Robiswell/Euler_Rover_2026/docs/README.md

# Identity Rover Documentation

[Back to main README](../README.md)

Detailed reference docs for the Identity rover build, organized so the main README can stay focused while reviewers can still inspect the full technical record.

## Build And Hardware

| Document | Purpose |
| --- | --- |
| [Hardware Reference](hardware.md) | Hardware stack, measured geometry, CAD links, tread construction, and BOM routing |
| [Bill of Materials](BOM.md) | Categorized purchasing BOM with source links, package quantities, and integration notes |
| [Purchasing BOM CSV](purchasing-bom.csv) | Exported source sheet used to build the categorized BOM |

## Software And Controls

| Document | Purpose |
| --- | --- |
| [Gait Control Reference](gait-control.md) | Buehler-clock gait modes, smart-servo feedback, gait visuals, and terrain overlays |
| [Software Map](software-map.md) | Runtime files, test programs, calibration tools, analysis helpers, and launch modes |
| [Architecture Overview](architecture.md) | Architecture diagrams and links to the full software architecture document |

## Validation And Media

| Document | Purpose |
| --- | --- |
| [Validation Reference](validation.md) | Field results, terrain signals, servo load margin, simulation coverage, and known limits |
| [Media Gallery](media.md) | Field demos and course success runs |
| [Presentation Slide Gallery](paper-presentation-slides.md) | View-friendly image gallery generated from the full paper presentation PDF |

## Releases

| Document | Purpose |
| --- | --- |
| [Release History](releases.md) | Public release trail for final, competition, and earlier rover milestones |
