Robiswell/Euler_Rover_2026/docs/architecture.md

# Architecture Overview

[Back to main README](../README.md)

Architecture reference for the Identity rover software stack, with diagram links and routing to the full software architecture document.

## Primary Architecture Document

See [`../ARCHITECTURE.md`](../ARCHITECTURE.md) for the full software architecture map, including the Brain/Heart process split, sensor pipeline, terrain overlay, safety governors, and simulation coverage.

## Runtime Split

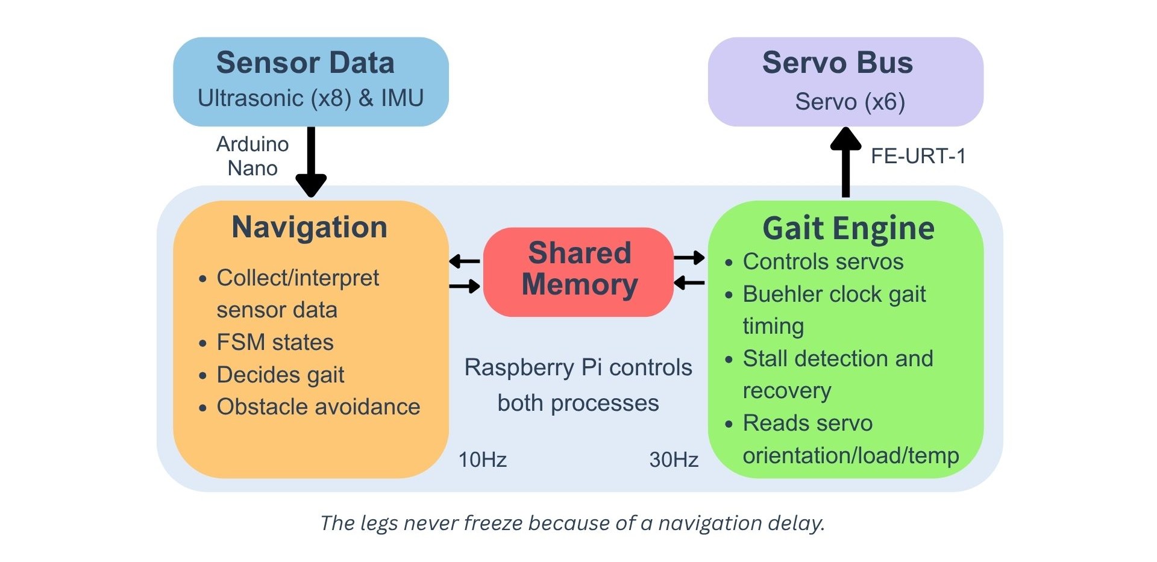
[picture p7: docs/assets/brain-heart-process-split.jpg]
Brain/Heart process split diagram


The Brain process handles sensor interpretation, terrain classification, obstacle/cliff logic, and navigation state transitions. The Heart process runs the timing-critical gait loop, computes servo commands, reads STS3215 position/load/speed telemetry, applies safety governors, and keeps motor control isolated from slower navigation work.

## System Diagram

Identity rover system architecture diagram
