Robiswell/Euler_Rover_2026/docs/paper-presentation-slides.md

# COSGC Symposium Paper Presentation Slides

[Back to main README](../README.md)

View-friendly slide gallery generated from the full presentation PDF so it can be browsed directly on GitHub. Use the README research table to download the full-resolution PDF release asset.

## Slide 1

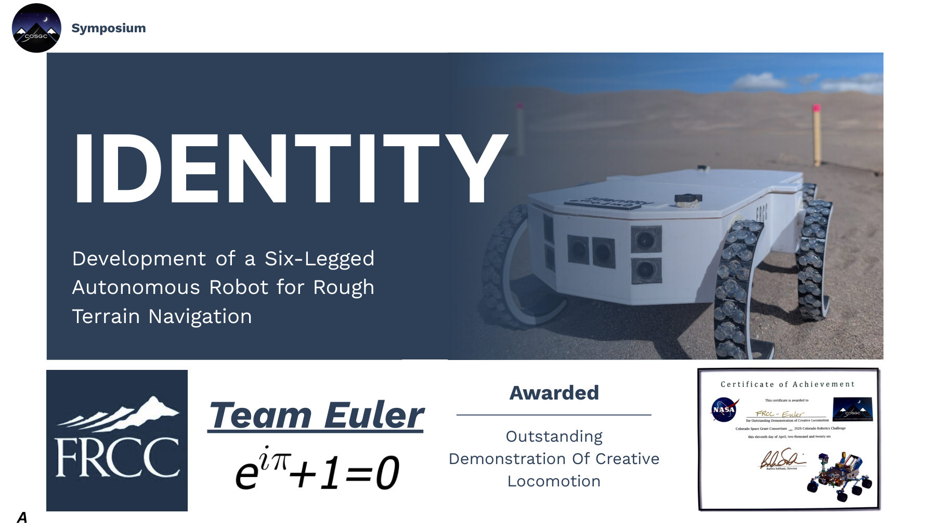
[picture p12: docs/assets/paper-presentation-slides/slide-01.jpg]
Slide 1


## Slide 2

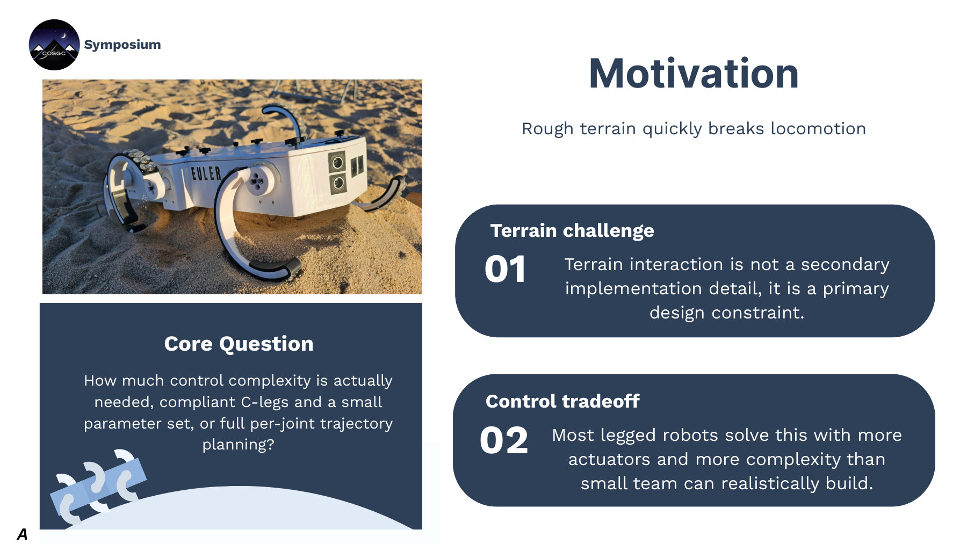
[picture p13: docs/assets/paper-presentation-slides/slide-02.jpg]
Slide 2


## Slide 3

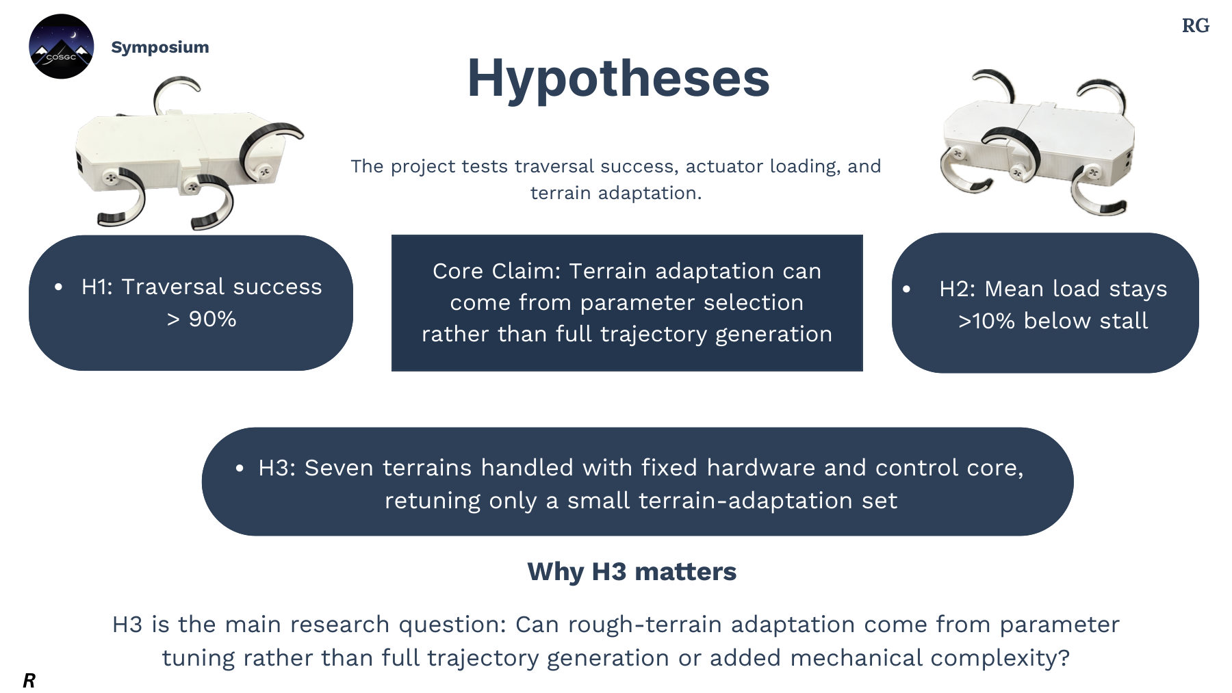
[picture p14: docs/assets/paper-presentation-slides/slide-03.jpg]
Slide 3


## Slide 4

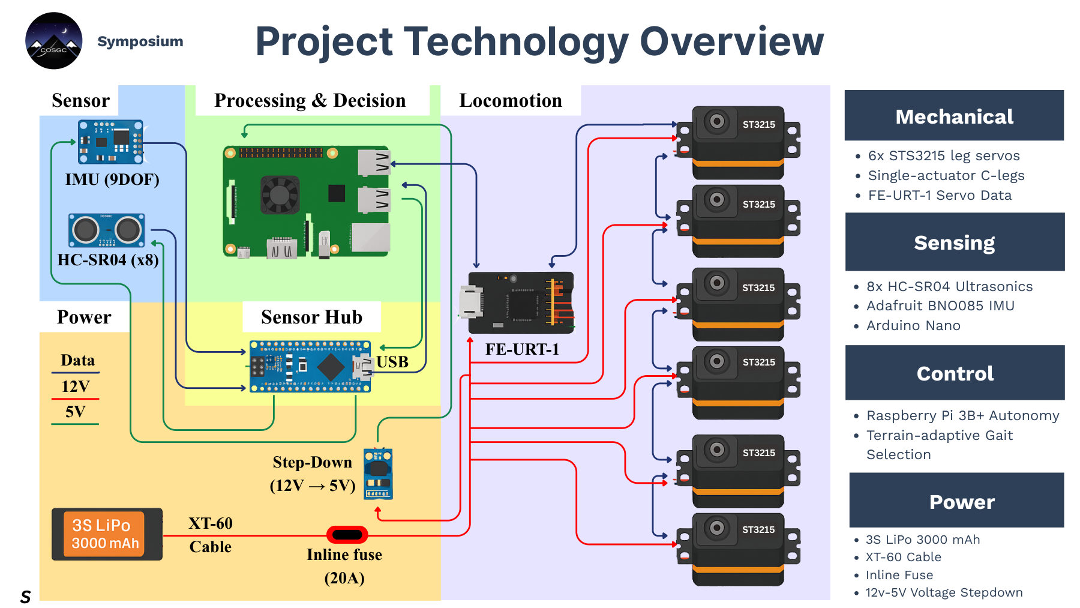
[picture p15: docs/assets/paper-presentation-slides/slide-04.jpg]
Slide 4


## Slide 5

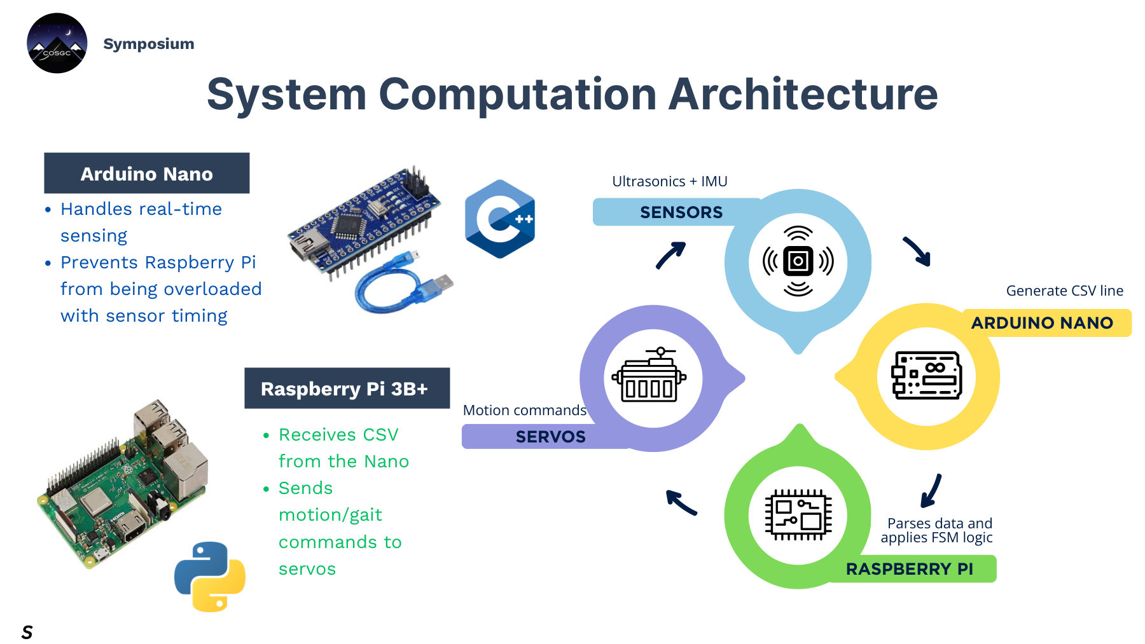
[picture p16: docs/assets/paper-presentation-slides/slide-05.jpg]
Slide 5


## Slide 6

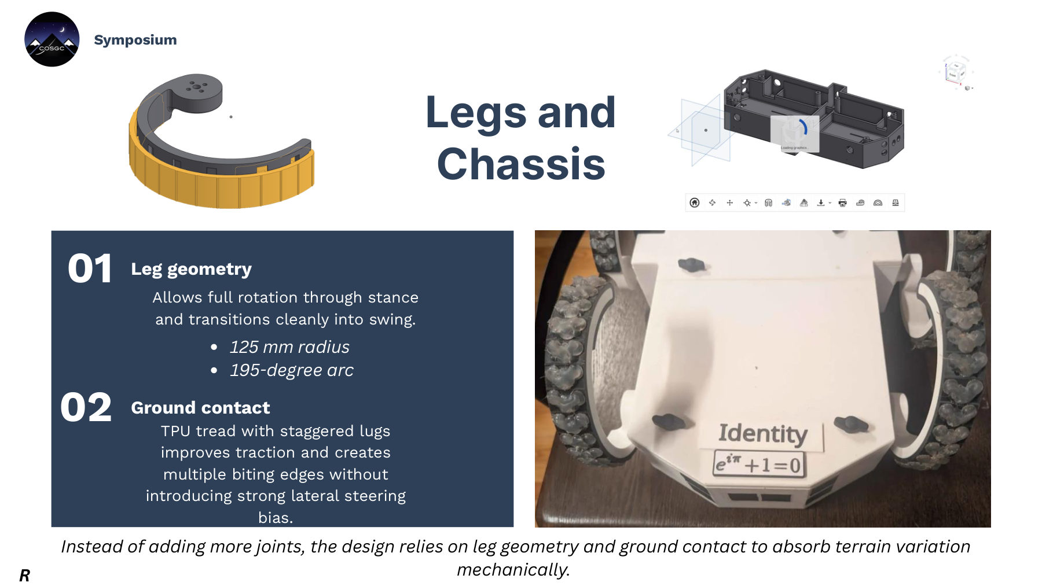
[picture p17: docs/assets/paper-presentation-slides/slide-06.jpg]
Slide 6


## Slide 7

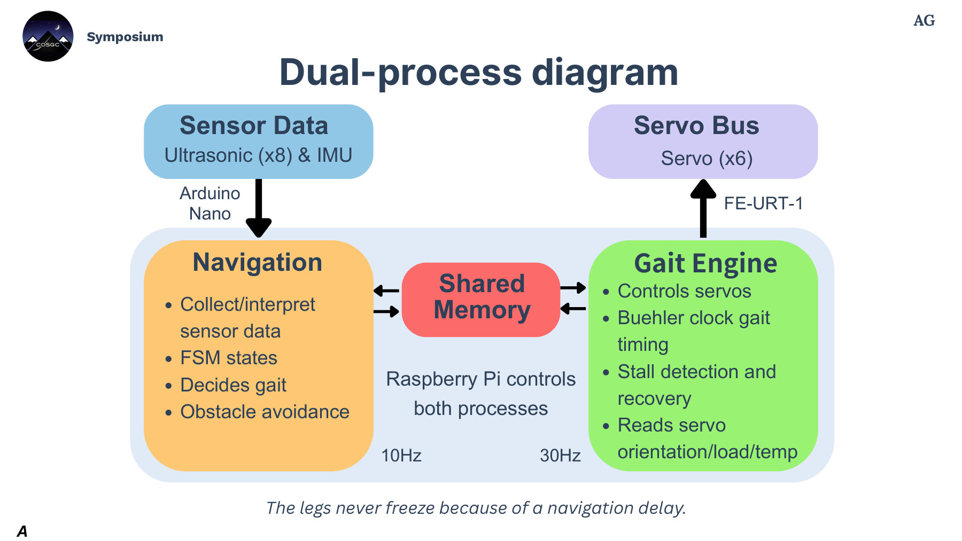
[picture p18: docs/assets/paper-presentation-slides/slide-07.jpg]
Slide 7


## Slide 8

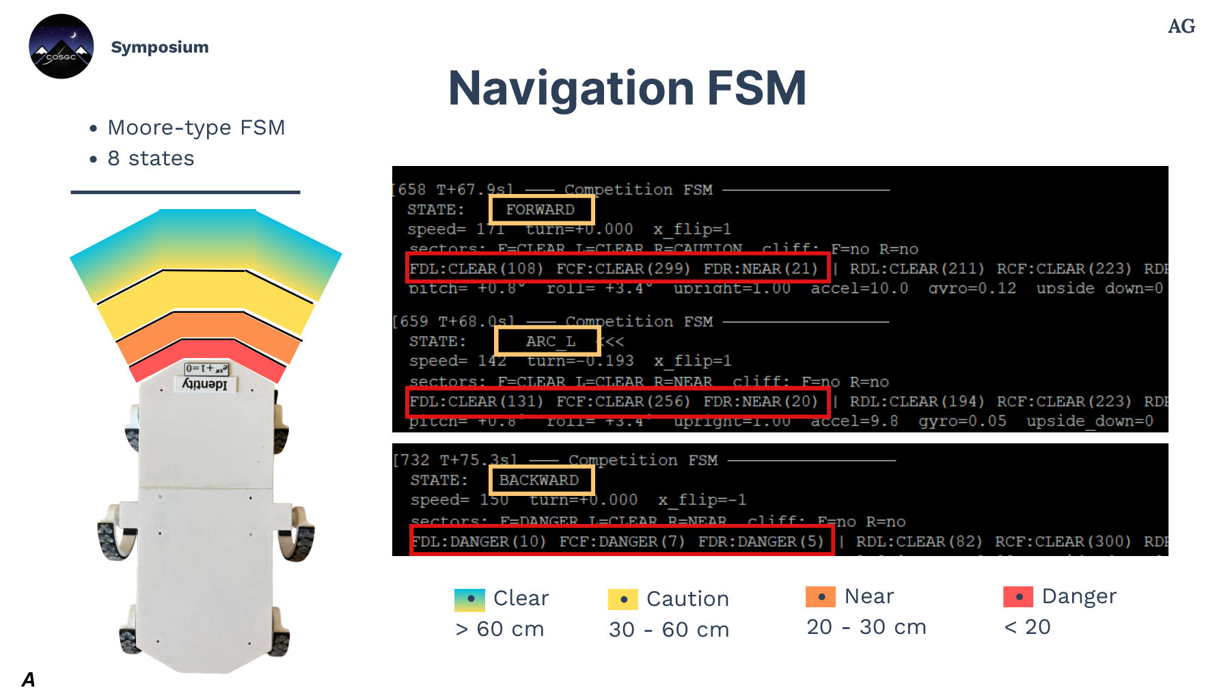
[picture p19: docs/assets/paper-presentation-slides/slide-08.jpg]
Slide 8


## Slide 9

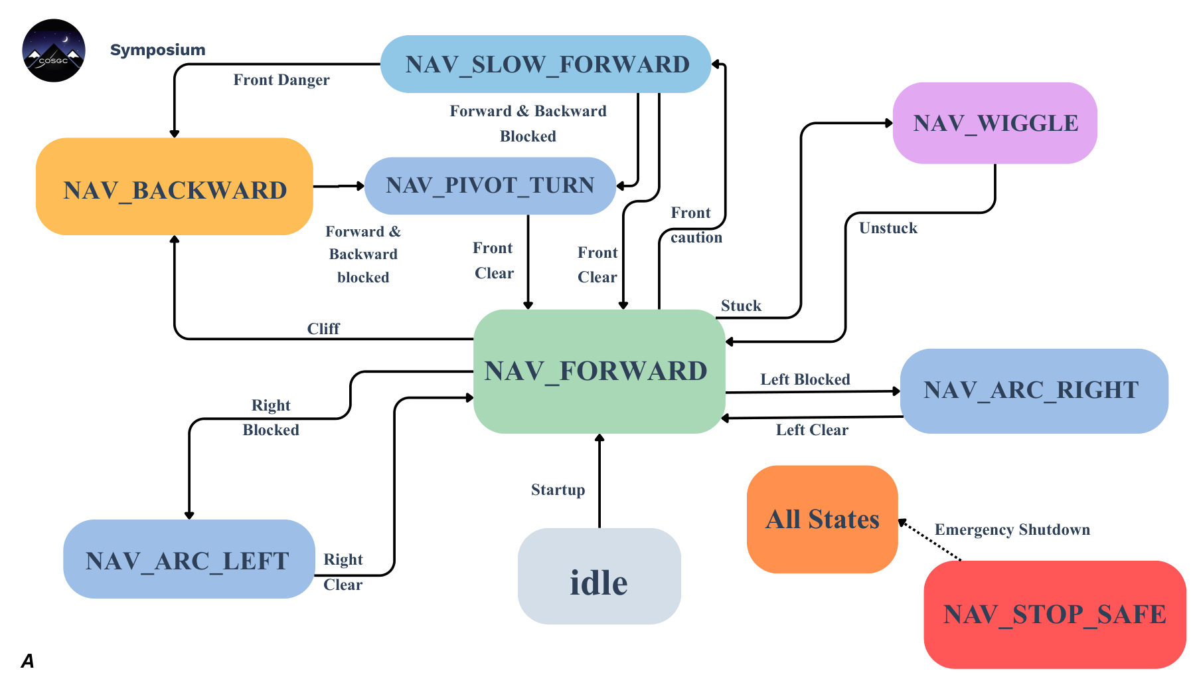
[picture p20: docs/assets/paper-presentation-slides/slide-09.jpg]
Slide 9


## Slide 10

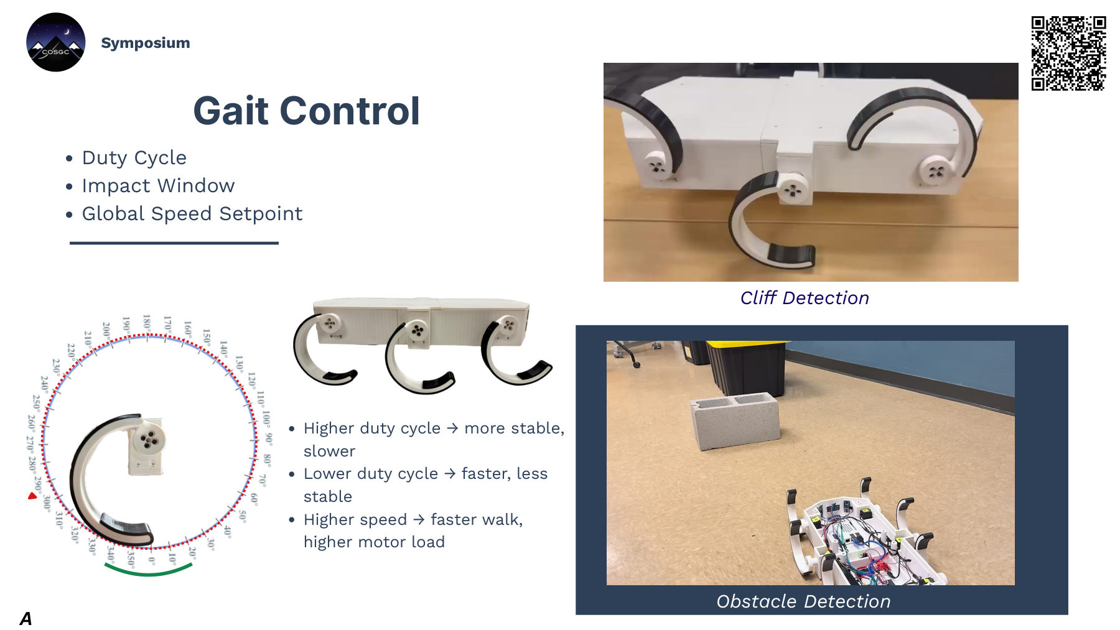
[picture p21: docs/assets/paper-presentation-slides/slide-10.jpg]
Slide 10


## Slide 11

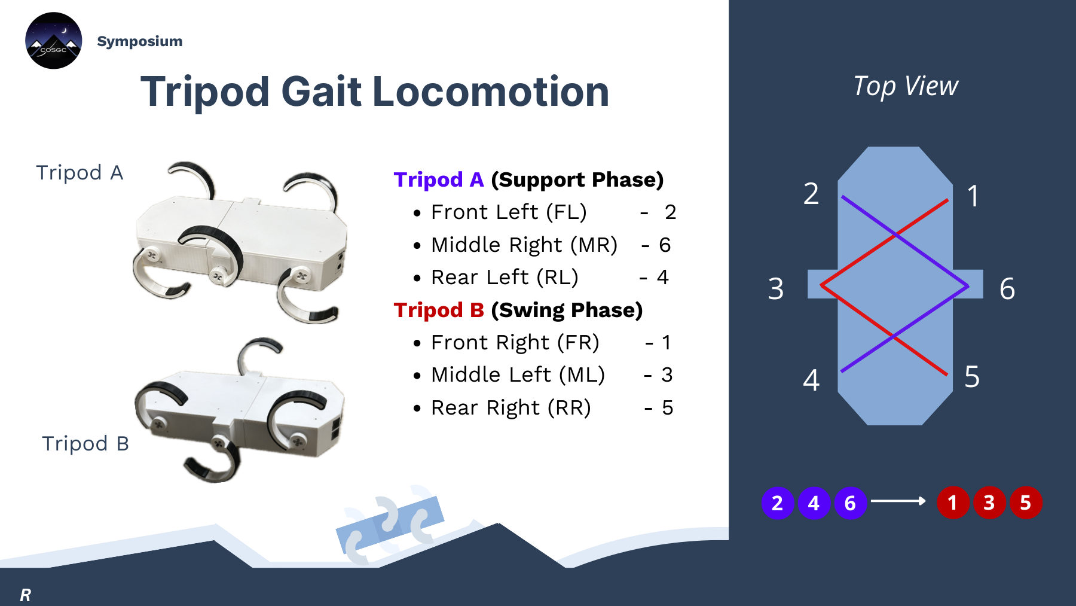
[picture p22: docs/assets/paper-presentation-slides/slide-11.jpg]
Slide 11


## Slide 12

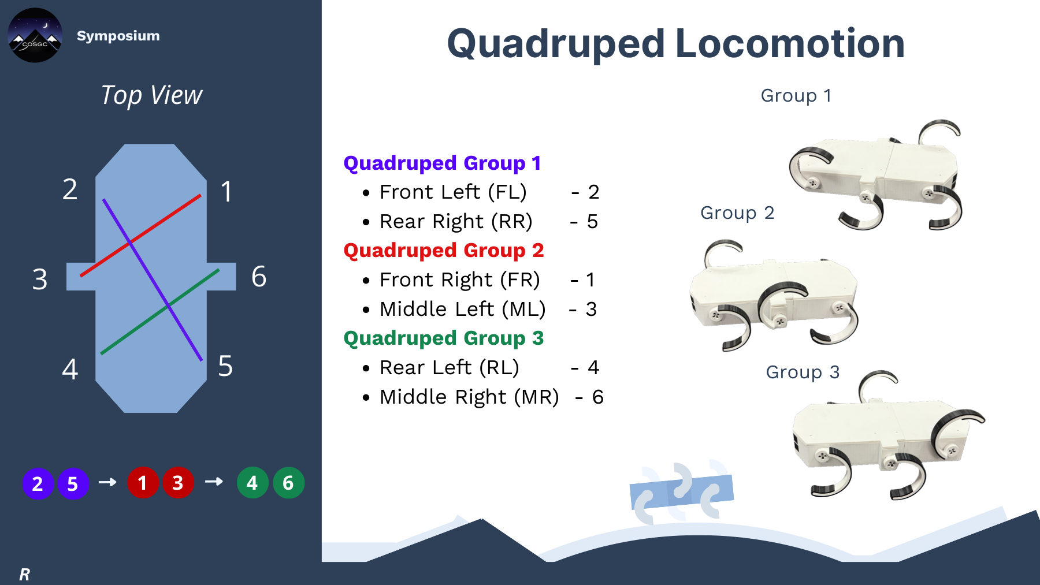
[picture p23: docs/assets/paper-presentation-slides/slide-12.jpg]
Slide 12


## Slide 13

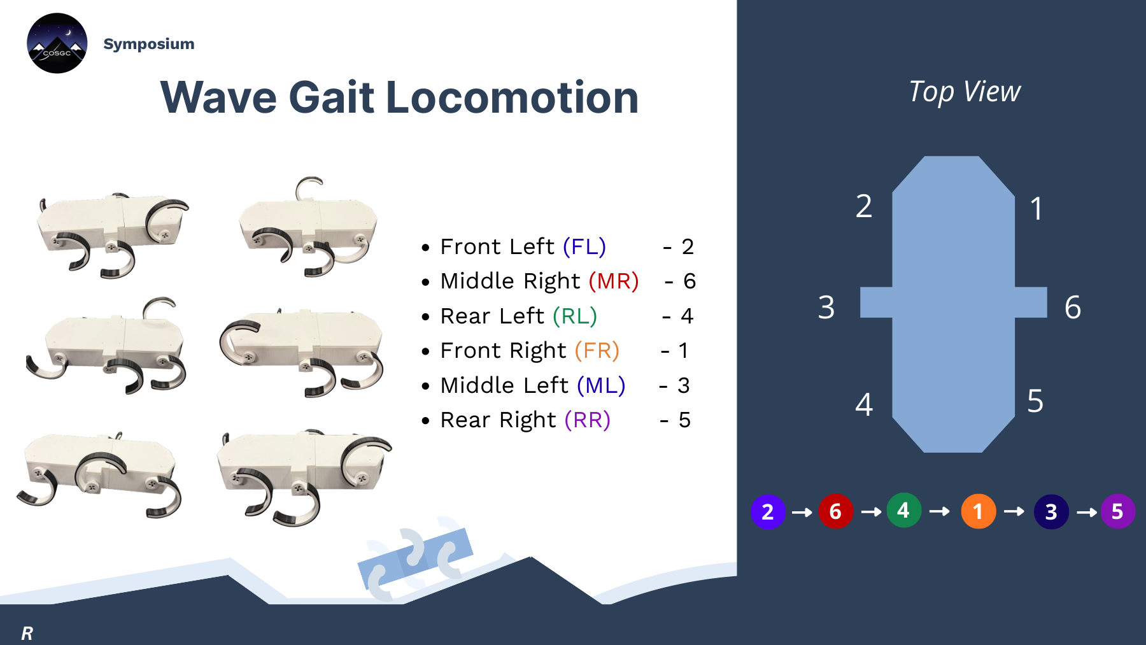
[picture p24: docs/assets/paper-presentation-slides/slide-13.jpg]
Slide 13


## Slide 14

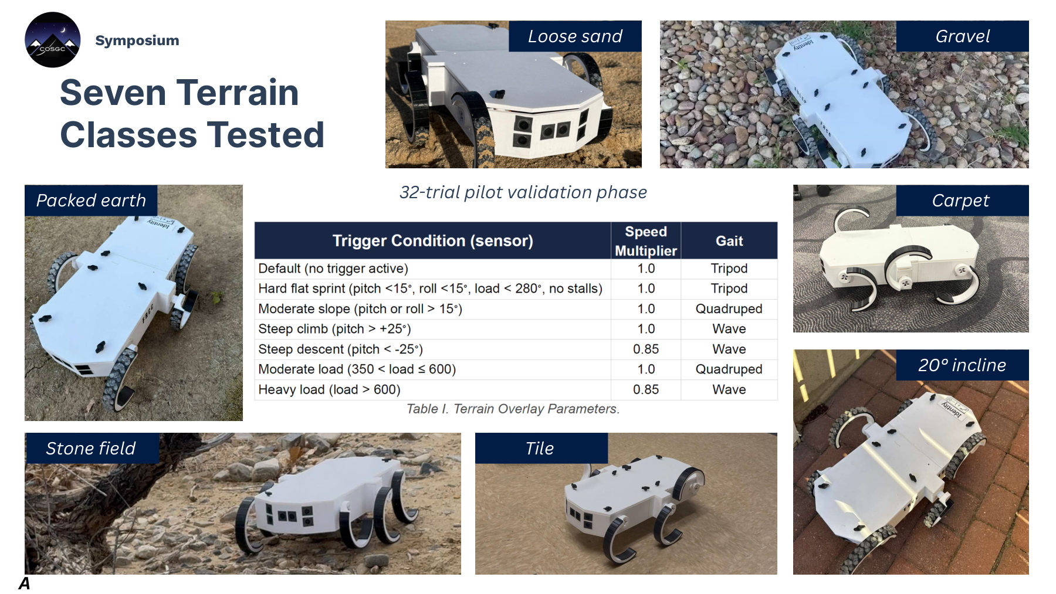
[picture p25: docs/assets/paper-presentation-slides/slide-14.jpg]
Slide 14


## Slide 15

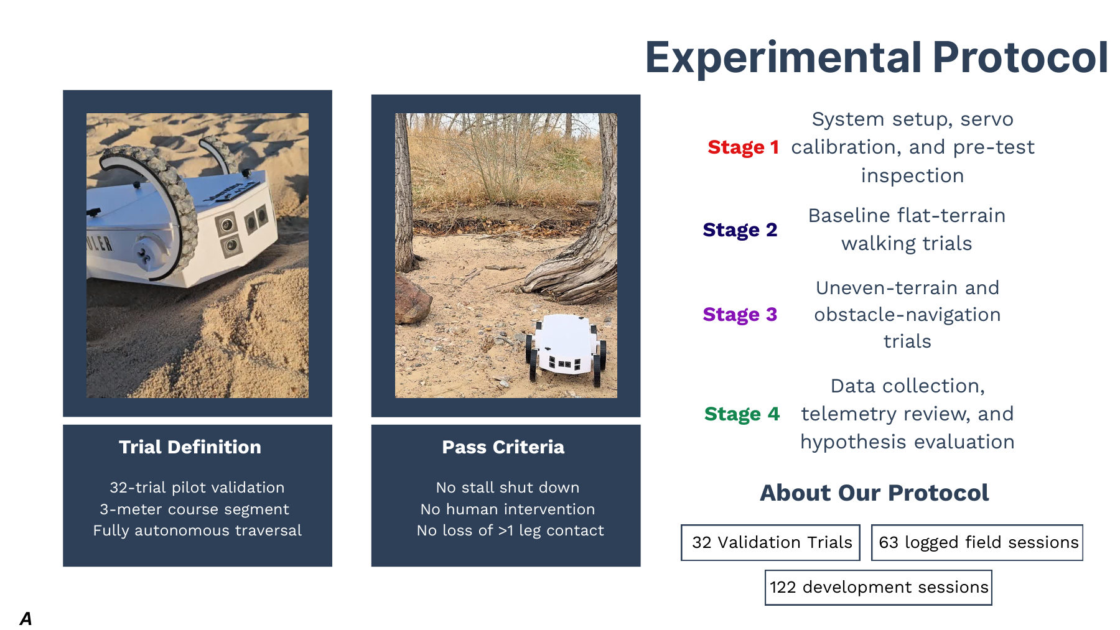
[picture p26: docs/assets/paper-presentation-slides/slide-15.jpg]
Slide 15


## Slide 16

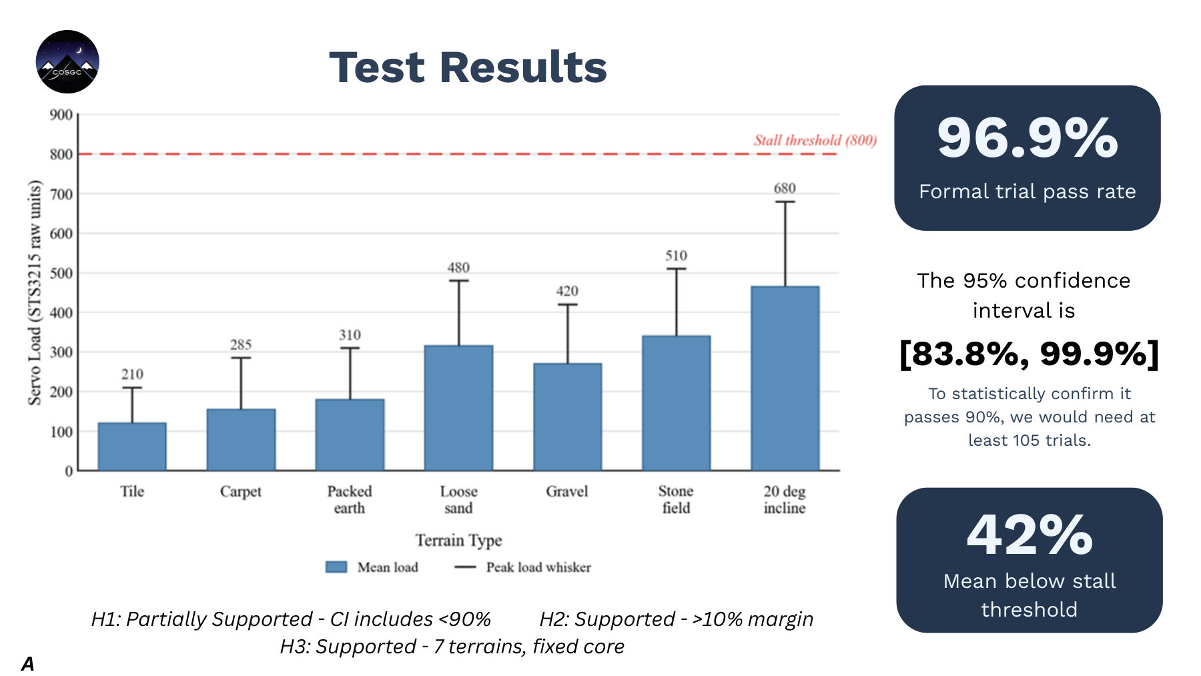
[picture p27: docs/assets/paper-presentation-slides/slide-16.jpg]
Slide 16


## Slide 17

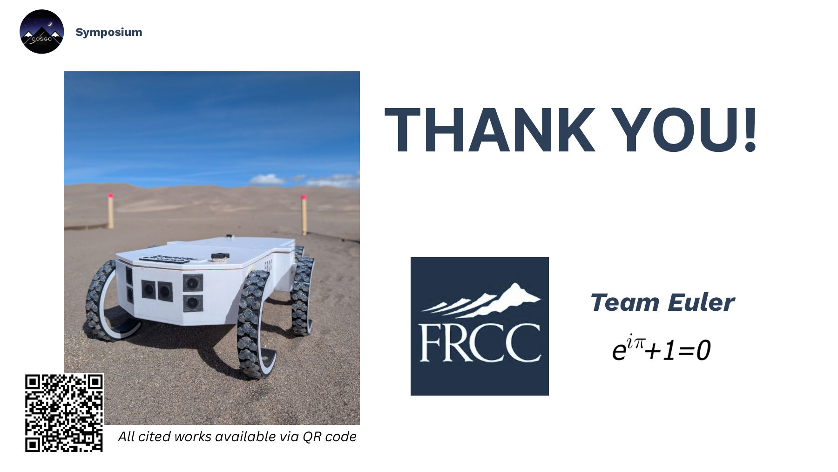
[picture p28: docs/assets/paper-presentation-slides/slide-17.jpg]
Slide 17
