Robiswell/Euler_Rover_2026/docs/media.md

# Media Gallery

[Back to main README](../README.md)

Full-resolution field-demo and course-success video downloads linked from the repository README. Links in the left column download MP4 files from the `media-assets` GitHub release; GIF previews on the right provide a quick visual check before downloading.

## Field Demo Videos

<table width="100%">
  <tr>
    <th width="34%" align="center" valign="middle">MP4 Download</th>
    <th width="66%" align="center" valign="middle">Preview</th>
  </tr>
  <tr>
    <td align="center"><a href="https://github.com/Robiswell/Euler_Rover_2026/releases/download/media-assets/sand-hill-traversal.mp4">Loose Sand Hill Traversal</a></td>
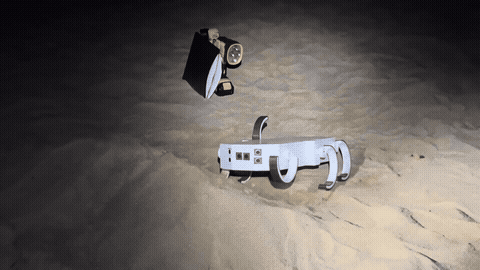
[picture p29: docs/assets/sand-hill-traversal-preview-v3.gif]
Sand hill traversal preview
    <td align="center"></td>
  </tr>
  <tr>
    <td align="center"><a href="https://github.com/Robiswell/Euler_Rover_2026/releases/download/media-assets/daytime-hill-traversal.mp4">Daytime Sand Hill Traversal</a></td>
    <td align="center"><a href="https://github.com/Robiswell/Euler_Rover_2026/releases/download/media-assets/daytime-hill-traversal.mp4">Daytime sand hill traversal preview</a></td>
  </tr>
  <tr>
    <td align="center"><a href="https://github.com/Robiswell/Euler_Rover_2026/releases/download/media-assets/cliff-detection-demo.mp4">Cliff Detection Behavior</a></td>
    <td align="center"><a href="https://github.com/Robiswell/Euler_Rover_2026/releases/download/media-assets/cliff-detection-demo.mp4">Cliff detection demo preview</a></td>
  </tr>
  <tr>
    <td align="center"><a href="https://github.com/Robiswell/Euler_Rover_2026/releases/download/media-assets/indoor-obstacle-navigation-demo.mp4">Indoor Obstacle Navigation</a></td>
    <td align="center"><a href="https://github.com/Robiswell/Euler_Rover_2026/releases/download/media-assets/indoor-obstacle-navigation-demo.mp4">Indoor obstacle navigation preview</a></td>
  </tr>
  <tr>
    <td align="center"><a href="https://github.com/Robiswell/Euler_Rover_2026/releases/download/media-assets/navigation-park-table-seating.mp4">Park Concrete Table Seating Navigation</a></td>
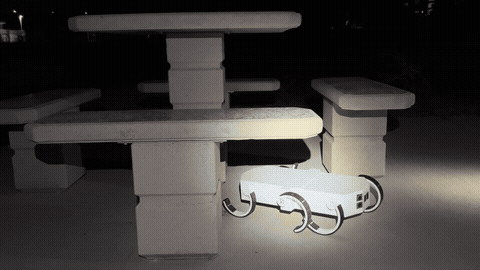
[picture p30: docs/assets/navigation-park-table-seating-preview-v4.gif]
Park concrete table seating navigation preview
    <td align="center"></td>
  </tr>
  <tr>
    <td width="34%"></td>
    <td width="66%"></td>
  </tr>
</table>

## Course Success Runs

<table width="100%">
  <tr>
    <th width="34%" align="center" valign="middle">MP4 Download</th>
    <th width="66%" align="center" valign="middle">Preview</th>
  </tr>
  <tr>
    <td align="center"><a href="https://github.com/Robiswell/Euler_Rover_2026/releases/download/media-assets/course-1-success.mp4">Course 1 Success</a></td>
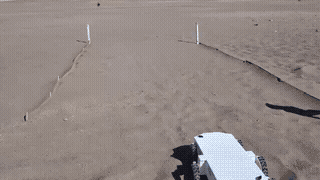
[picture p31: docs/assets/course-1-success-preview-v3.gif]
Course 1 success preview
    <td align="center"></td>
  </tr>
  <tr>
    <td align="center"><a href="https://github.com/Robiswell/Euler_Rover_2026/releases/download/media-assets/course-2-success.mp4">Course 2 Success</a></td>
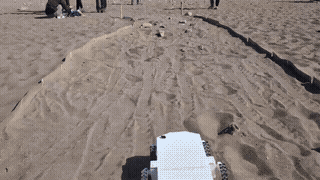
[picture p32: docs/assets/course-2-success-preview-v3.gif]
Course 2 success preview
    <td align="center"></td>
  </tr>
  <tr>
    <td align="center"><a href="https://github.com/Robiswell/Euler_Rover_2026/releases/download/media-assets/course-3-success.mp4">Course 3 Success</a></td>
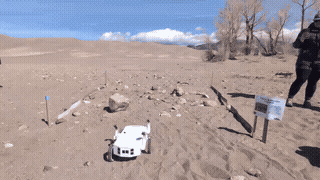
[picture p33: docs/assets/course-3-success-preview-v3.gif]
Course 3 success preview
    <td align="center"></td>
  </tr>
  <tr>
    <td align="center"><a href="https://github.com/Robiswell/Euler_Rover_2026/releases/download/media-assets/course-4-success.mp4">Course 4 Success</a></td>
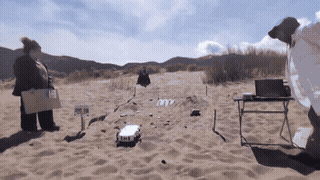
[picture p34: docs/assets/course-4-success-preview-v3.gif]
Course 4 success preview
    <td align="center"></td>
  </tr>
  <tr>
    <td align="center"><a href="https://github.com/Robiswell/Euler_Rover_2026/releases/download/media-assets/course-5-success.mp4">Course 5 Success</a></td>
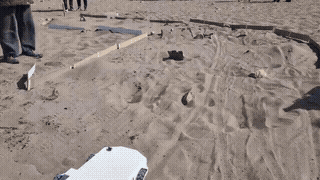
[picture p35: docs/assets/course-5-success-preview-v3.gif]
Course 5 success preview
    <td align="center"></td>
  </tr>
  <tr>
    <td align="center"><a href="https://github.com/Robiswell/Euler_Rover_2026/releases/download/media-assets/challenge-course-success.mp4">Challenge Course Success</a></td>
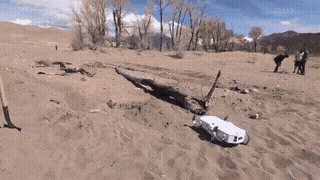
[picture p36: docs/assets/challenge-course-success-preview-v3.gif]
Challenge course success preview
    <td align="center"></td>
  </tr>
  <tr>
    <td width="34%"></td>
    <td width="66%"></td>
  </tr>
</table>
