Robiswell/Euler_Rover_2026/docs/assets/identity-cosgc-2026-award-video-preview-v2.gif

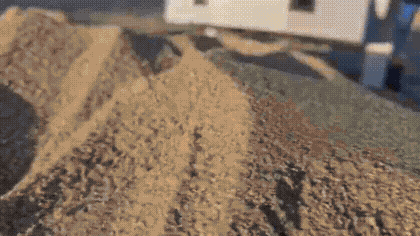
docs/assets/identity-cosgc-2026-award-video-preview-v2.gif
