Robiswell/Euler_Rover_2026/final_full_gait_test.py

#!/usr/bin/env python3
"""
Hexapod rover kinematics - STS3215 servos, Raspberry Pi 3B+

Two processes:
  Brain  - mission sequencer, runs gait phases and recovery behaviors
  Heart  - 30Hz kinematics loop, Buehler clock math + LERP smoothing

Hardware: 6x STS3215 12V servos on /dev/ttyUSB1 @ 1Mbaud
No software angle offsets - clearance is managed physically.

Usage:
  sudo python3 final_full_gait_test.py [MODE]

Modes:
  (no args)              Demo mode - full maneuver showcase (all gaits + stances)
  --competition          Autonomous nav - 8-state FSM, Arduino sensors, terrain adaptation (prints real-time FSM state/speed/turn/gait/sensors to terminal)
  --competition-dry-run  Autonomous nav with speed=0 - sensors active, logs transitions only (same FSM terminal output, servos stay still)
  --test-competition     Timed fallback - quad@400 45s then wave@350 30s (no sensors)
  --test-tripod          Tripod gait only - forward, carve, pivot, reverse
  --test-quad            Quadruped gait only - forward, carve, pivot, reverse, walking tall, stealth crawl
  --test-wave            Wave gait only - forward, carve, pivot, reverse, COG shift hill climb
  --test-recovery        Recovery behaviors only - wiggle + self-right roll
  --test-arduino         Serial reader test - print 20 Arduino frames, report health (no Heart)
  --test-sensors         Sensor processing test - classify sectors, cliff, IMU, turn intensity
  --test-nav             Full nav pipeline test - Arduino -> parse -> classify -> FSM transitions
  --no-verbose-telemetry Disable extended telemetry ([H5] servo detail, [BS] sensor, [BN] nav)
"""

import time
import sys
import signal
import datetime                                                                                                                                                                                                                                                                                                                                                                                                                                                                                                                                                                                                                                                                                                                                                                                                                                                                                                                                                                                                                                                                                                                                                                                                                                                                                                                                                                                                                                                                                                                                                                                                                                                                                                                                                                                                                                                                                                                                                                                                                                                                                                                                                                                                                                                                                                                                                                                                                                                                                                                                                                                                                                                                                                                                                                                                                                                                                                                                                                                                                     
import os
import multiprocessing as mp
import gc
import math
import collections
import socket
import threading

# --- OPTIONAL: pyserial for autonomous nav (Arduino sensor hub) ---
try:
    import serial
    HAS_SERIAL = True
except ImportError:
    HAS_SERIAL = False

# --- HARDWARE SDK INTEGRITY CHECK ---
try:
    from scservo_sdk import (PortHandler, PacketHandler,
                             GroupSyncWrite, GroupSyncRead)
except ImportError:
    print("\n" + "!"*60)
    print("[CRITICAL ERROR] scservo_sdk (SCServo SDK) is not installed.")
    print("Please install it to run on hardware: pip install scservo_sdk")
    print("!"*60 + "\n")
    sys.exit(1)

# =================================================================
# HARDWARE CONFIGURATION & REGISTER MAPPING
# =================================================================
PORT_NAME      = "/dev/ttyUSB1"
BAUDRATE       = 1000000
SERVO_PROTOCOL = 0

# STS3215 Register Map
ADDR_MODE             = 33
ADDR_TORQUE_ENABLE    = 40
ADDR_ACCEL            = 41
ADDR_GOAL_POSITION    = 42
ADDR_GOAL_SPEED       = 46
ADDR_TORQUE_LIMIT     = 16
ADDR_PRESENT_POSITION = 56
ADDR_PRESENT_SPEED    = 58
ADDR_PRESENT_LOAD     = 60
ADDR_PRESENT_VOLTAGE  = 62
ADDR_PRESENT_TEMP     = 63
ADDR_HARDWARE_ERROR   = 65  # S5: 6 error flags in 1 byte (overvoltage, sensor, overtemp, overcurrent, angle, overload)
ADDR_PRESENT_CURRENT  = 69
LEN_GOAL_SPEED        = 2
LEN_PRESENT_POSITION  = 2
LEN_PRESENT_LOAD      = 2
LEN_PRESENT_SPEED     = 2
LEN_PRESENT_TEMP      = 1
LEN_PRESENT_VOLTAGE   = 1
LEN_PRESENT_CURRENT   = 2

# Robot Physical Constants
ENCODER_RESOLUTION = 4096.0
VELOCITY_SCALAR    = 1.85
LEFT_SERVOS        = [2, 3, 4]
RIGHT_SERVOS       = [1, 6, 5]
ALL_SERVOS         = LEFT_SERVOS + RIGHT_SERVOS
ROLL_FRONT_SERVOS        = {1, 2}   # Fix 76: counter-rotating front pair for self-right
ROLL_REAR_SERVOS         = {4, 5}   # Fix 76: counter-rotating rear pair for self-right
SERVO_SPEED_GOVERNOR_CAP = 499     # Speed ceiling for roll/self-right mode (walking uses GOVERNOR_FF_BUDGET)
WALKING_SPEED_CAP        = 1200    # STS -- walking mode clamp: ff(499) + phase correction for up to ~58 deg error

# Body Geometry (measured from physical robot — verified from physical robot measurements)
# These values are the foundation for all ground-clearance calculations.
#   h(θ) = LEG_EFFECTIVE_RADIUS × cos(θ)  — chassis height above ground at leg angle θ
#   clearance = h(θ) − SHAFT_TO_CHASSIS_BOTTOM  — must stay > MIN_GROUND_CLEARANCE
LEG_EFFECTIVE_RADIUS    = 125.0    # mm — C-leg geometry: servo shaft at arc endpoint, not center (full diameter = radius, corrected 2026-03-19)
LEG_DIAMETER            = 125.0    # mm — outer tip-to-tip across leg arc (12.5 cm measured); for C-legs, effective radius = diameter (shaft at endpoint)
LEG_ARC_DEGREES         = 190.0    # degrees — physical arc of the curved leg (190° measured, constrains max stance sweep)
SHAFT_TO_CHASSIS_BOTTOM = 47.0     # mm — shaft center to chassis bottom (servo mounting block height 4.7 cm measured)
MIN_GROUND_CLEARANCE    = 15.0     # mm — minimum safe clearance (restored: r=125mm gives 78mm static clearance)
GOVERNOR_CLEARANCE_MARGIN = 5.0    # mm — extra safety buffer in clearance governor (restored: r=125mm has ample headroom)
FEEDFORWARD_CAP         = 499.0    # STS raw units -- matches STS3215 no-load max (45 RPM = 270 deg/s * 1.85)
GOVERNOR_FF_BUDGET      = 575.0    # STS raw units — default fallback; per-gait 'ff_budget' in GAITS dict overrides this
DEFAULT_IMPACT_START    = 340      # walking stance start angle (40 deg sweep)
DEFAULT_IMPACT_END      = 20       # walking stance end angle
QUAD_IMPACT_START       = 330      # quad-specific: wider 60 deg sweep — Quad duty=0.70 → air=30%, motor margin ~16% at max Hz
QUAD_IMPACT_END         = 30       # quad air sweep = 300 deg (vs 330 default) — STS3215 can track this

# Body Dimensions (final mechanical design appendix — measured from physical robot)
BODY_LENGTH         = 511.0   # mm — total front-to-back (51.1 cm)
BODY_WIDTH          = 220.0   # mm — total side-to-side (22.0 cm)
CHASSIS_HEIGHT      = 80.0    # mm — total chassis height side view (8.0 cm)
SERVO_SPACING       = 175.0   # mm — shaft center-to-center, adjacent same side (17.5 cm)
CORNER_CHAMFER      = 40.0    # mm — front chamfer vertical side (4.0 cm)
CHAMFER_HORIZONTAL  = 69.0    # mm — front chamfer horizontal side (6.9 cm)
FRONT_SERVO_OFFSET  = 40.0    # mm — front chassis edge to front servo shaft center (4.0 cm)
REAR_SERVO_OFFSET   = 121.0   # mm — rear chassis edge to rear servo shaft center (511 - 40 - 2×175)
SHAFT_TO_TOP        = 33.0    # mm — shaft center to top face (CHASSIS_HEIGHT - SHAFT_TO_CHASSIS_BOTTOM)

# Roll-aware clearance constants (for turn governor -- see hardware.md)
# During turns, differential leg speeds create body roll. The chassis corner
# on the inside of the turn drops closer to the ground. These constants let
# the governor compute the extra clearance loss from roll.
W_SHAFT             = 160.0   # mm — left-right servo shaft plane distance (BODY_WIDTH - 2*30mm servo Y-offset)
CORNER_OVERHANG     = 30.0    # mm — chassis corner extends beyond servo shaft plane (servo Y-offset)
ROLL_SAFETY_FACTOR  = 2.0     # multiplier — accounts for dynamic bounce during walking turns

# Phase-Error Governor — throttles gait clock when servos can't track commanded phase
# Exponential ramp from CPG paper (Sensors 2019, 19(17), 3705, Eqs. 20-21)
PHERR_ENGAGE_DEG   = 30.0   # deg — engage governor when max servo phase error exceeds this
PHERR_RELEASE_DEG  = 20.0   # deg — release governor (hysteresis band prevents toggle)
PHERR_FLOOR_SCALE  = 0.45   # minimum Hz multiplier at full throttle (45% of max_safe_hz)
PHERR_RAMP_WIDTH   = 120.0  # deg — exponential ramp width (gentle near threshold, aggressive at high error)
PHERR_STUCK_TIMEOUT = 5.0   # sec — if governor stays at floor for this long, escalate to stall/wiggle
KAPPA_GOVERNOR     = 3.0    # exponential decay rate (gentler than KAPPA_TRANSITION=12.0 for gait switches)
MIN_STANCE_HZ      = 0.15   # Hz -- absolute floor after PhErr governor; prevents positive feedback loop
KAPPA_STARTUP      = 1.5    # offset ramp rate at cold start (95% in 2.0s — prevents phase death spiral)
KAPPA_GAIT_SWITCH  = 1.5    # offset ramp rate during gait transitions (95% in 2.0s)
OFFSET_CONVERGE_THRESH = 0.02  # offset convergence threshold (7.2 deg) — ramp done when all offsets within this

# Industrial Safety Parameters
TEMP_MAX     = 65  # lowered from 70 — altitude reduces convective cooling ~25%
VOLTAGE_MIN  = 10.5  # 10.5V = 3.5V/cell floor — raised from 10.0 for cold-weather cell protection (no hardware BMS)
BROWNOUT_VOLTAGE_START = 11.0   # Start throttling governor Hz at this voltage (just above low-battery zone)
BROWNOUT_SPEED_FLOOR   = 0.5    # Floor multiplier on max_safe_hz at VOLTAGE_MIN (50% speed)
assert BROWNOUT_VOLTAGE_START > VOLTAGE_MIN, "BROWNOUT_VOLTAGE_START must exceed VOLTAGE_MIN to avoid division by zero"
# Current budget governor — throttle Hz when total fleet current approaches BEC limit
# STS3215 stall current ~2.1A/servo; 6 servos at full load = 12.6A; BEC typically 8-10A
CURRENT_BUDGET_WARN_MA  = 8000   # 8A total — start throttling (~1.3A/servo avg)
CURRENT_BUDGET_HARD_MA  = 10500  # 10.5A total — hard floor (1.75A/servo avg, 12.5% below 2A overcurrent trip)
CURRENT_BUDGET_FLOOR    = 0.65   # floor multiplier — skipped when PhErr active (mutual exclusion)
assert CURRENT_BUDGET_HARD_MA > CURRENT_BUDGET_WARN_MA, "CURRENT_BUDGET_HARD_MA must exceed WARN to avoid division by zero"
LOG_FILE     = "telemetry_log.txt"
LOG_MAX_SIZE = 10 * 1024 * 1024

# Phase Error Governor — breaks the PhErr positive feedback loop
# (see Hexapod Phase Error Accumulation Root Cause Analysis, 2026-03-17)
# When PhErr is below PHERR_DEADBAND, no correction is applied (noise floor).
PHERR_DEADBAND          = 6.0     # degrees — no phase correction below this (noise floor)

# Mirrored Physical Mounting Map
DIRECTION_MAP = {
    1: 1,   # Right Front
    2: -1,  # Left Front (Inverted)
    3: -1,  # Left Middle (Inverted)
    4: -1,  # Left Rear (Inverted)
    5: 1,   # Right Rear
    6: 1,   # Right Middle
}

# V0.5.01 New Constants for calibrated home positions and stall detection tuning for wet sand operation.
# Calibrated zero points (Legs pointing straight down)
HOME_POSITIONS = {
    1: 4004, 2: 1099, 3: 3333,
    4: 980,  5: 3460, 6: 927,
}

# Servo ID -> shared_servo_loads array index (0-based, clean mapping)
SERVO_LOAD_INDEX = {sid: i for i, sid in enumerate(ALL_SERVOS)}

# Feedback Gains
KP_PHASE        = 15.0
STALL_THRESHOLD = 800  # raised from 750 — wet sand+stones reach 700-750 normally; 800 still below 818 hw cutoff
GHOST_TEMP      = 125  # STS3215 EMI artifact - bus noise returns flat 125°C (not a real reading)
OVERLOAD_PREVENTION_TIME = 1.2  # seconds — clear overload flag before 2s hardware cutoff (reduced from 1.5 for more margin)
OVERLOAD_MAX_CYCLES = 50  # max TE cycles per servo per session — raised from 10 for competition sand (EEPROM rated 100k writes)
OVERLOAD_DECAY_INTERVAL = 30.0  # seconds without overload before decaying 1 cycle from counter

# Verbose Telemetry — ON by default. Adds [H5] servo detail (5Hz), [BS] sensor (2Hz), [BN] nav decision lines.
# Disable with --no-verbose-telemetry. Total overhead: ~1.6 KB/s, <1 MB for a 10-minute run.
VERBOSE_TELEMETRY = "--no-verbose-telemetry" not in sys.argv

# --- KINEMATIC GAIT DICTIONARIES ---
GAITS = {
    0: {  # TRIPOD — do NOT use on slopes >10°: peak servo torque exceeds rated 10 kg·cm.
        #         Use Wave with COG shift for ramps (see Phase 3 hill climb).
        'duty': 0.55,
        'ff_budget': 475.0,  # lowered — matches 250 deg/s loaded speed (carpet); PhErr governor adapts for heavier terrain
        'offsets': {2: 0.0, 6: 0.0, 4: 0.0,  1: 0.5, 3: 0.5, 5: 0.5}
    },
    1: {  # WAVE — metachronal wave, rear-to-front, alternating sides (R-L-R-L-R-L)
        'duty': 0.75,  # reverted from 0.80 — 0.80 caused 92% motor demand in air, servos couldn't keep up
        # Lift order: 5(RR)→3(LM)→1(RF)→4(LR)→6(RM)→2(LF)
        # Each consecutive pair in the air is on OPPOSITE sides AND different
        # columns, guaranteeing the support polygon always spans the full body.
        #
        # Previous offsets ({5:0,4:0.166,...}) had same-COLUMN overlaps:
        # legs 5(RR)+4(LR) both rear, 6(RM)+3(LM) both middle, 1(RF)+2(LF)
        # both front -- these pairs are simultaneously in air (old duty=0.75,
        # air=0.25 > spacing=0.166), leaving entire rows unsupported and
        # causing the chassis edge to hit the ground.
        #
        # New pattern interleaves columns: rear->middle->front per side.
        # Spacing 0.167; with duty=0.80, same-column legs are >=0.5 apart
        # (air=0.20), so no same-column overlap is possible.
        'ff_budget': 465.0,  # lowered — matches 250 deg/s loaded speed (carpet); PhErr governor adapts for heavier terrain
        'offsets': {2: 0.0, 6: 0.167, 4: 0.333, 1: 0.5, 3: 0.667, 5: 0.833}
    },
    2: {  # QUADRUPED
        'duty': 0.70,
        'ff_budget': 465.0,  # lowered — matches 250 deg/s loaded speed (carpet); PhErr governor adapts for heavier terrain
        'offsets': {2: 0.0, 5: 0.0,  1: 0.333, 3: 0.333,  4: 0.667, 6: 0.667}
    }
}

# -----------------------------------------------------------------
# CPG / HOPF OSCILLATOR PARAMETERS (Sensors-19-03705)
# -----------------------------------------------------------------
# Exponential ramp rate κ for smooth gait transitions.
# Controls convergence speed of duty (ε) and phase offset (φ) ramps.
# κ·dt ≈ 0.27 at 30 Hz → 95% settled in ~0.32 s (paper recommends 0.5–1.0 s).
KAPPA_TRANSITION = 8.0  # 1/s — exponential decay rate for φ/ε ramps

# Adjacent-leg pairs: no two adjacent legs may be in swing (air) simultaneously.
# Layout: RIGHT front→back = 1,6,5 | LEFT front→back = 2,3,4
# Adjacency includes ipsilateral neighbours AND contralateral front/rear pairs.
ADJACENT_LEGS = {
    1: [6, 2],    # R-front  ↔ R-mid, L-front
    6: [1, 5],    # R-mid    ↔ R-front, R-rear
    5: [6, 4],    # R-rear   ↔ R-mid, L-rear
    2: [3, 1],    # L-front  ↔ L-mid, R-front
    3: [2, 4],    # L-mid    ↔ L-front, L-rear
    4: [3, 5],    # L-rear   ↔ L-mid, R-rear
}

# -----------------------------------------------------------------
# KINEMATIC CORE HELPERS
# -----------------------------------------------------------------
def compute_max_safe_speed(impact_start, impact_end, duty, ff_cap=FEEDFORWARD_CAP):
    """
    Maximum cycle frequency (Hz) where air-phase feedforward stays below
    the cap, avoiding phase lag that reduces chassis ground clearance.

    Physics:
      Air-phase angular velocity = air_sweep × freq / (1 − duty)
      Feedforward = angular_velocity × VELOCITY_SCALAR
      For ff ≤ cap:  freq ≤ cap / (VELOCITY_SCALAR × air_sweep / (1 − duty))

    Returns (max_hz, max_speed_int) where max_speed_int = int(max_hz × 1000).
    """
    stance_sweep = (impact_end - impact_start + 180) % 360 - 180
    air_sweep_deg = 360.0 - abs(stance_sweep)
    if air_sweep_deg < 1.0:
        return 10.0, 9999  # degenerate — near-zero air sweep, no practical limit
    max_deg_per_sec = ff_cap / VELOCITY_SCALAR   # 269.7 °/s at cap=499
    max_hz = max_deg_per_sec * (1.0 - duty) / air_sweep_deg
    return max_hz, int(max_hz * 1000)


def _max_angle_from_vertical(impact_start, impact_end):
    """
    Maximum angle (degrees) from vertical (0°/360°) that occurs during
    the stance sweep from impact_start to impact_end.

    For symmetric sweeps (e.g. 330°/30°) this equals half_sweep.
    For asymmetric sweeps (e.g. 315°/15°) the center is offset from
    vertical, so the worst angle = offset + half_sweep > half_sweep.

    Physics (Sensors-19-03705 §3):
      h(θ) = r·cos(θ) — chassis height depends on angle from vertical.
      Minimum clearance occurs at the maximum |θ| during stance.
      For a sweep centered at angle c from vertical with half-width w,
      the worst angle is |c| + w.
    """
    # Deviation from vertical for each endpoint
    s = impact_start % 360
    e = impact_end % 360
    dev_s = min(s, 360.0 - s)
    dev_e = min(e, 360.0 - e)
    return max(dev_s, dev_e)


def compute_min_clearance(impact_start, impact_end, phase_lag_deg=0.0):
    """
    Minimum chassis ground clearance (mm) during stance phase,
    accounting for phase-tracking lag at stance start.

    Physics (Sensors-19-03705 §3, adapted):
      At the worst stance angle θ_max, the leg deviates furthest from vertical.
      For asymmetric sweeps, θ_max ≠ half_sweep — we compute the actual
      maximum angle from vertical across both endpoints.
      With phase lag, the effective angle is θ_max + lag.
      h(θ) = LEG_EFFECTIVE_RADIUS × cos(θ)
      clearance = h(θ) − SHAFT_TO_CHASSIS_BOTTOM
    """
    worst_angle = _max_angle_from_vertical(impact_start, impact_end) + phase_lag_deg
    h = LEG_EFFECTIVE_RADIUS * math.cos(math.radians(worst_angle))
    return h - SHAFT_TO_CHASSIS_BOTTOM


def compute_max_clearance_hz(impact_start, impact_end, duty,
                             min_clearance=MIN_GROUND_CLEARANCE,
                             ff_cap=FEEDFORWARD_CAP, kp=KP_PHASE,
                             turn_bias=0.0):
    """
    Maximum cycle frequency (Hz) that maintains minimum ground clearance,
    accounting for phase lag from feedforward cap clipping and body roll
    during turns.

    Physics (Sensors-19-03705 S3, adapted for servo dynamics):
      When air-phase feedforward exceeds ff_cap, it is clipped.
      The remaining error is corrected by KP_PHASE at ~kp deg/STS,
      creating a steady-state phase lag = (ff_needed - ff_cap) / kp.
      At stance entry, the leg angle = worst_static_angle + phase_lag.
      For asymmetric sweeps, worst_static_angle > half_sweep.
      clearance = LEG_EFFECTIVE_RADIUS * cos(angle) - SHAFT_TO_CHASSIS_BOTTOM
      During turns, roll_drop from compute_roll_corner_drop() is added to
      the clearance requirement, tightening the Hz limit.
      Solving for max_hz where clearance = min_clearance + roll_drop.

    Returns max_hz (float).  Caller converts to speed via int(max_hz * 1000).
    """
    stance_sweep = (impact_end - impact_start + 180) % 360 - 180
    worst_static = _max_angle_from_vertical(impact_start, impact_end)
    air_sweep = 360.0 - abs(stance_sweep)

    if air_sweep < 1.0 or duty >= 0.99:
        return 10.0  # degenerate -- near-zero air sweep, no practical limit

    # Roll-aware: add corner drop from body tilt during turns
    roll_drop = compute_roll_corner_drop(turn_bias, worst_static, duty)
    effective_clearance = min_clearance + roll_drop

    # Max angle from vertical that still gives effective_clearance
    ratio = (SHAFT_TO_CHASSIS_BOTTOM + effective_clearance) / LEG_EFFECTIVE_RADIUS
    if ratio >= 1.0:
        return 0.0  # geometry cannot provide clearance even at rest
    max_total_angle = math.degrees(math.acos(ratio))

    max_lag = max(0.0, max_total_angle - worst_static)
    if max_lag <= 0.0:
        return 0.0  # impact angles already too wide for clearance at rest

    # max_ff = cap + allowable lag * kp  (invert lag = (ff - cap) / kp)
    max_ff = ff_cap + max_lag * kp
    max_deg_per_sec = max_ff / VELOCITY_SCALAR
    max_hz = max_deg_per_sec * (1.0 - duty) / air_sweep
    return max_hz


def compute_roll_corner_drop(turn_bias, worst_angle, duty):
    """
    Extra clearance loss (mm) at the inside chassis corner from body roll
    during a turn.

    Physics:
      Differential leg speeds (hz_L != hz_R) create asymmetric stance heights.
      Inside legs run faster -> larger worst_angle -> lower h(theta).
      The height difference across W_SHAFT tilts the chassis, and the corner
      overhang amplifies the drop:
        delta_h = r * |cos(theta_outside) - cos(theta_inside)|
        corner_drop = CORNER_OVERHANG * delta_h / W_SHAFT * ROLL_SAFETY_FACTOR

      The inside leg's worst angle is increased by the turn_bias fraction of
      the air sweep, modeling faster rotation on the inside.
    """
    if abs(turn_bias) < 0.001:
        return 0.0

    # Inside leg sees a larger effective angle due to faster rotation.
    # Turn bias shifts the inside leg's phase, widening its worst angle.
    # The 0.5 is a linearization coefficient: actual phase lag depends on
    # feedforward dynamics, but 0.5 * ROLL_SAFETY_FACTOR(2.0) ~= 1.0 net,
    # giving a first-order approximation. Validate on hardware.
    # duty is accepted but not yet used -- reserved for future duty-dependent
    # roll modeling (higher duty = more stance time = more constrained roll).
    bias_angle_shift = abs(turn_bias) * worst_angle * 0.5
    theta_inside = math.radians(worst_angle + bias_angle_shift)
    theta_outside = math.radians(max(0.0, worst_angle - bias_angle_shift))

    h_inside = LEG_EFFECTIVE_RADIUS * math.cos(theta_inside)
    h_outside = LEG_EFFECTIVE_RADIUS * math.cos(theta_outside)
    delta_h = abs(h_outside - h_inside)

    # Corner overhang amplifies the tilt
    corner_drop = CORNER_OVERHANG * delta_h / W_SHAFT * ROLL_SAFETY_FACTOR
    return corner_drop


def get_air_sweep(stance_sweep):
    """
    Authoritative air-phase sweep calculation.
    Extracted into a single helper to avoid duplicated sign logic.
    """
    air = 360.0 - abs(stance_sweep)
    return -air if stance_sweep < 0 else air


def get_buehler_angle(t_norm, duty_cycle, start_ang, end_ang, is_reversed):
    """
    Pure geometric mapping for stutter-free 360-degree rotation.
    Handles stance/air phases with magnitude-based feed-forward logic.
    """
    stance_sweep = (end_ang - start_ang + 180) % 360 - 180

    if is_reversed:
        start_ang, end_ang = end_ang, start_ang
        stance_sweep = -stance_sweep

    if t_norm <= duty_cycle:
        progress = t_norm / duty_cycle
        angle = start_ang + (stance_sweep * progress)
    else:
        progress = (t_norm - duty_cycle) / (1.0 - duty_cycle)
        air_sweep = get_air_sweep(stance_sweep)
        angle = end_ang + (air_sweep * progress)

    return angle % 360


def cpg_asymmetric_omega(base_hz, duty, t_leg):
    """
    Hopf-CPG asymmetric frequency (Sensors-19-03705 Eq. 8).

    During stance (t_leg <= duty) the oscillator advances slower,
    during swing (t_leg > duty) it advances faster, so that the
    total cycle period is preserved while the duty split is honoured.

    Returns the phase-rate multiplier to apply to base_hz for this tick.

    Math:  ω_stance = 1 / duty          (normalised so stance·ω_s + swing·ω_sw = 1)
           ω_swing  = 1 / (1 − duty)
    The caller already integrates master_time += |hz| * real_dt, so we
    return a dimensionless scale factor.

    NOTE: Not called in the Heart loop because the Buehler clock's
    stance/air split already implements this asymmetry geometrically
    (different angular sweeps in different time fractions). Exposed
    for Brain-level analysis, testing, and future CPG extensions.
    """
    if duty <= 0.01 or duty >= 0.99:
        return 1.0  # degenerate — fall back to uniform rate
    if t_leg <= duty:
        return 1.0 / duty        # stance: slower phase advance
    else:
        return 1.0 / (1.0 - duty)  # swing: faster phase advance


def cpg_exp_ramp(current, target, kappa, dt):
    """
    Exponential parameter ramp (Sensors-19-03705 Eq. 12/13).

    φ(t) = φ_target + (φ_current − φ_target) · e^(−κ·dt)

    Replaces linear LERP for smoother, monotonic convergence.
    At κ=8, dt=0.02: factor ≈ 0.85 → 95% settled in ~0.6 s.
    """
    decay = math.exp(-kappa * dt)
    return target + (current - target) * decay


def cpg_exp_ramp_circular(current, target, kappa, dt, period=1.0):
    """
    Circular-aware exponential ramp for phase offsets in [0, period).

    Computes shortest-arc delta, applies exponential decay, wraps result.
    """
    half = period / 2.0
    delta = (target - current + half) % period - half  # shortest signed delta
    new_target = current + delta  # unwrapped target
    result = cpg_exp_ramp(current, new_target, kappa, dt)
    return result % period


def cpg_check_adjacent_swing(smooth_offsets, smooth_duty, master_time_L, master_time_R):
    """
    Adjacent-swing stability check (Sensors-19-03705 Section 4.2).

    Returns True if no two adjacent legs are simultaneously in swing phase.
    Used as a diagnostic — does NOT block commands (safety is via offsets).
    """
    in_swing = {}
    for sid in ALL_SERVOS:
        mt = master_time_L if sid in LEFT_SERVOS else master_time_R
        t_leg = (mt + smooth_offsets[sid]) % 1.0
        in_swing[sid] = (t_leg > smooth_duty)

    for sid, neighbours in ADJACENT_LEGS.items():
        if in_swing.get(sid, False):
            for nbr in neighbours:
                if in_swing.get(nbr, False):
                    return False  # violation: two adjacent legs both in swing
    return True  # stable


# =================================================================
# PROCESS 2: THE HEART (REAL-TIME ENGINE)
# =================================================================
def gait_worker(shared_speed, shared_x_flip, shared_z_flip, shared_turn_bias, shared_gait_id,
                shared_impact_start, shared_impact_end, shared_servo_loads, shared_servo_speeds,
                shared_heartbeat, shared_stall_override, shared_roll_mode, shared_voltage, is_running):
    """
    30Hz kinematics loop. Runs as a separate process.
    GroupSyncRead for position and load every tick. Temp/voltage/current
    rotate one servo per tick to avoid unnecessary bus traffic.
    """
    signal.signal(signal.SIGINT, signal.SIG_IGN)

    def _sigterm_handler(signum, frame):
        """Allow finally block to run on SIGTERM from Brain."""
        is_running.value = False

    signal.signal(signal.SIGTERM, _sigterm_handler)

    try:
        os.nice(-20)
    except:
        pass

    # Drain heap during boot before disabling GC for the live loop
    gc.collect()
    gc.disable()

    port_handler   = PortHandler(PORT_NAME)
    packet_handler = PacketHandler(SERVO_PROTOCOL)

    # Sync write: goal speeds (sent every loop)
    group_sync_write = GroupSyncWrite(
        port_handler, packet_handler, ADDR_GOAL_SPEED, LEN_GOAL_SPEED)

    # Sync read: present position (every loop)
    gsread_pos = GroupSyncRead(
        port_handler, packet_handler, ADDR_PRESENT_POSITION, LEN_PRESENT_POSITION)

    # Sync read: load - all servos every tick (required for stall detection)
    gsread_load = GroupSyncRead(port_handler, packet_handler, ADDR_PRESENT_LOAD, LEN_PRESENT_LOAD)

    # Sync read: present speed - all servos every tick (for terrain speed_error)
    gsread_speed = GroupSyncRead(port_handler, packet_handler, ADDR_PRESENT_SPEED, LEN_PRESENT_SPEED)

    # Temp / voltage / current use individual reads on the single rotating telemetry_sid.
    # GroupSyncRead for these would register all 6 servos and fire a 6-servo transaction
    # every tick, tripling bus traffic for registers we only need from one servo per tick.

    port_handler.setPacketTimeoutMillis(10)

    # Internal Tracking
    is_stalled     = {sid: False for sid in ALL_SERVOS}
    stall_counters = {sid: 0     for sid in ALL_SERVOS}
    stall_sustained_start = {sid: 0.0 for sid in ALL_SERVOS}  # timestamp of sustained stall onset (0.0 = not timing)
    overload_cycle_count = {sid: 0 for sid in ALL_SERVOS}
    overload_last_decay  = {sid: time.perf_counter() for sid in ALL_SERVOS}  # timestamp of last decay tick
    overload_lifetime    = {sid: 0 for sid in ALL_SERVOS}     # total TE cycles ever (for EEPROM tracking)
    te_dwell_remaining = {sid: 0 for sid in ALL_SERVOS}
    last_actual_phases = {sid: 0.0 for sid in ALL_SERVOS}

    telemetry_sid   = ALL_SERVOS[0]   # Which single servo gets full telemetry this tick
    telemetry_index = 0
    voltage_reading = 12.0
    brownout_scale  = 1.0
    volt_dip_counter   = 0
    temp_spike_counters = {sid: 0 for sid in ALL_SERVOS}  # per-servo overtemp tracking
    temp_per_servo     = {sid: 0 for sid in ALL_SERVOS}   # Last known temp per servo (°C)
    current_per_servo  = {sid: 0 for sid in ALL_SERVOS}   # Last known current per servo (raw mA units)
    hw_error_per_servo = {sid: 0 for sid in ALL_SERVOS}  # S5: hardware error flags per servo (addr 65)
    parent_pid     = os.getppid()
    # UDP telemetry broadcast (fire-and-forget, non-blocking)
    udp_sock = socket.socket(socket.AF_INET, socket.SOCK_DGRAM)
    udp_sock.setsockopt(socket.SOL_SOCKET, socket.SO_BROADCAST, 1)
    udp_sock.setblocking(False)
    # UDP command listener (receives STOP from laptop command sender)
    cmd_sock = socket.socket(socket.AF_INET, socket.SOCK_DGRAM)
    cmd_sock.setsockopt(socket.SOL_SOCKET, socket.SO_REUSEADDR, 1)
    cmd_sock.bind(("0.0.0.0", 9877))
    cmd_sock.setblocking(False)
    last_log_time  = 0

    # Verbose telemetry: [H5] servo detail at 5Hz (every 6th tick of 30Hz loop)
    h5_buffer  = []       # buffered [H5] lines, drained at 1Hz with log_telemetry
    h5_counter = 0        # tick counter for 5Hz decimation
    cmd_speeds     = {sid: 0 for sid in ALL_SERVOS}    # per-servo commanded speed (raw units)
    phase_angles   = {sid: 0.0 for sid in ALL_SERVOS}  # per-servo actual phase from encoders (degrees)
    target_angles  = {sid: 0.0 for sid in ALL_SERVOS}  # per-servo Buehler target phase (degrees)

    GAIT_NAMES = {0: "tripod", 1: "wave", 2: "quad"}

    def log_telemetry(volt, total_amps, fsm_speed, fsm_turn,
                      volt_dip_ctr, temp_spike_ctr, loop_ms, ghost_event):
        """Extended telemetry log — per-servo loads, stall IDs, safety counters, loop timing.
        Fields: timestamp, gait, speed, turn | voltage + volt_dip_counter | per-servo temps +
        temp_spike_counter | per-servo loads | stall servo IDs | amps | loop_ms | event tags.
        [GHOST] = 125C EMI artifact rejected this tick.
        [V_WARN:N] = volt_dip_counter > 100 (shutdown triggers at > 150).
        [T_WARN:N] = temp_spike_counter > 10 (shutdown triggers at > 15).
        """
        try:
            if os.path.exists(LOG_FILE) and os.path.getsize(LOG_FILE) > LOG_MAX_SIZE:
                os.rename(LOG_FILE, LOG_FILE + f".{int(time.time())}.old")
            with open(LOG_FILE, "a") as f:
                ts        = datetime.datetime.now().strftime("%H:%M:%S")
                gait_name = GAIT_NAMES.get(shared_gait_id.value, str(shared_gait_id.value))
                # Per-servo temps and loads in ALL_SERVOS order (2,3,4,1,6,5)
                temps_str = ",".join(str(temp_per_servo[sid]) for sid in ALL_SERVOS)
                loads_str = ",".join(str(shared_servo_loads[SERVO_LOAD_INDEX[sid]]) for sid in ALL_SERVOS)
                stall_ids = ",".join(f"s{sid}" for sid in ALL_SERVOS if is_stalled[sid]) or "none"
                ghost_tag = " [GHOST]" if ghost_event else ""
                vwarn_tag = f" [V_WARN:{volt_dip_ctr}]" if volt_dip_ctr > 100 else ""
                twarn_tag = f" [T_WARN:{temp_spike_ctr}]" if temp_spike_ctr > 10 else ""
                phgov_tag = f" [PhGov:{int(round((1.0 - ph_scale) * 100))}%]" if pherr_gov_active else ""
                # Tier 2 diagnostic fields (appended to existing format)
                jit_max = max(dt_samples) if dt_samples else 0.0
                jit_mean = sum(dt_samples) / len(dt_samples) if dt_samples else 0.0
                jit_std = (sum((x - jit_mean) ** 2 for x in dt_samples) / len(dt_samples)) ** 0.5 if dt_samples else 0.0
                gov_pct = int(round(gov_clamp_count * 100 / max(1, len(dt_samples)))) if dt_samples else 0
                te_str = ",".join(str(te_cycle_counts[sid]) for sid in ALL_SERVOS)
                stall_dur_parts = []
                for s in ALL_SERVOS:
                    if stall_entry_time[s] > 0:
                        sd = time.perf_counter() - stall_entry_time[s]
                        stall_dur_parts.append(f"s{s}={sd:.1f}s")
                stall_dur_str = ",".join(stall_dur_parts) if stall_dur_parts else "none"
                # S4: per-servo position error (commanded vs actual) for post-run diagnostics
                pos_errs = {sid: abs(target_angles.get(sid, 0) - actual_phases.get(sid, 0)) for sid in ALL_SERVOS}
                pos_errs = {sid: min(e, 360 - e) for sid, e in pos_errs.items()}  # wrap to [0,180]
                max_pos_err = max(pos_errs.values()) if pos_errs else 0.0
                _hb_line = (f"[{ts}] G:{gait_name} Spd:{fsm_speed} Trn:{fsm_turn:.2f} | "
                        f"V:{volt:.2f}V Vc:{volt_dip_ctr:03d} | "
                        f"T:{temps_str} Tc:{temp_spike_ctr:02d} | "
                        f"L:{loads_str} | Stall:{stall_ids} | "
                        f"A:{total_amps:.2f} | Loop:{loop_ms:.1f}ms"
                        f"{ghost_tag}{vwarn_tag}{twarn_tag}{phgov_tag}"
                        f"{'[BROWNOUT]' if brownout_scale < 1.0 else ''}"
                        f" | Pdelta:{pos_delta_accum} Jit:{jit_max:.1f}/{jit_std:.1f}ms"
                        f" Gov:{gov_pct:02d}% TE:{te_str} PhErr:{ref_phase_error:+.1f}° MaxPhErr:{max_phase_error_prev:.1f}° PG:{int(pherr_gov_active)}"
                        f" Comm:{comm_fail_streak:02d} StDur:{stall_dur_str}"
                        f" PosErr:{max_pos_err:.1f}°"
                        f"{' HwErr:' + ','.join(f's{sid}={hw_error_per_servo[sid]:02x}' for sid in ALL_SERVOS if hw_error_per_servo[sid]) if any(hw_error_per_servo.values()) else ''}\n")
                f.write(_hb_line)
                # UDP broadcast heartbeat (fire-and-forget for live analyst)
                try:
                    udp_sock.sendto(_hb_line.encode("utf-8"), ("255.255.255.255", 9876))
                except Exception:
                    pass
        except:
            pass

    _stall_log_buffer = []

    def log_stall_event(sid, entering, load):
        """Buffer stall events in memory — flushed in Heart finally block.
        entering=True → stall declared (counter hit 3). entering=False → stall cleared (counter hit 0).
        """
        try:
            ts    = datetime.datetime.now().strftime("%H:%M:%S.%f")[:-3]
            event = "ENTRY" if entering else "EXIT "
            total_stalled = sum(1 for s in is_stalled.values() if s)
            pos = raw_positions.get(sid, 0)
            base = (f"[{ts}] [STALL-{event}] servo=s{sid} load={load} "
                    f"thresh={STALL_THRESHOLD} concurrent_stalls={total_stalled} "
                    f"pos={pos} cmd_spd={shared_speed.value} ff_spd={ref_ff_speed:.1f}")
            if not entering:
                dur = (time.perf_counter() - stall_entry_time[sid]) * 1000 if stall_entry_time[sid] > 0 else 0
                te_fired = te_during_stall.get(sid, 0) > 0
                _stall_log_buffer.append(f"{base} dur={dur:.0f}ms te_fired={te_fired}")
            else:
                _stall_log_buffer.append(base)
        except:
            pass

    def flush_stall_log():
        """Write buffered stall events to disk. Called once at shutdown."""
        if not _stall_log_buffer:
            return
        try:
            with open(LOG_FILE, "a") as f:
                for line in _stall_log_buffer:
                    f.write(line + "\n")
            _stall_log_buffer.clear()
        except:
            pass

    def flush_ring_buffer(tag, count=50, trigger_desc=""):
        """Dump last `count` ring buffer entries to LOG_FILE with [tag] header."""
        try:
            entries = list(ring_buffer)[-count:]
            if not entries:
                return
            lines = [f"[{tag}] {len(entries)} ticks, trigger: {trigger_desc}\n"]
            for e in entries:
                (t_off, p1, p2, p3, p4, p5, p6,
                 l1, l2, l3, l4, l5, l6,
                 cmd_spd, cmd_trn, ff_spd, ph_ang, gid,
                 st_bm, ldt, gov, xf, zf) = e
                lines.append(
                    f"T+{t_off:08.3f} P:{p1:04d},{p2:04d},{p3:04d},{p4:04d},{p5:04d},{p6:04d} "
                    f"L:{l1:03d},{l2:03d},{l3:03d},{l4:03d},{l5:03d},{l6:03d} "
                    f"Cmd:{cmd_spd:04d}/{cmd_trn:+.2f} FF:{ff_spd:05.1f} Ph:{ph_ang:05.1f} "
                    f"G:{gid} St:{st_bm:02d} dt:{ldt:04.1f} Gov:{int(gov)} Dir:{xf:+d}/{zf:+d}\n"
                )
            with open(LOG_FILE, "a") as f:
                f.write("".join(lines))
        except:
            pass

    def init_and_align_servos():
        """Boot: snap all legs to home in position mode, then switch to velocity mode."""
        port_retries = 0
        while is_running.value:
            if port_handler.openPort() and port_handler.setBaudRate(BAUDRATE):
                print(f"[heart] port {PORT_NAME} opened at {BAUDRATE} baud")
                break
            port_retries += 1
            if port_retries % 5 == 0:
                print(f"[heart] waiting for {PORT_NAME}... ({port_retries} retries)")
            if port_retries >= 30:
                print(f"[heart] FATAL: {PORT_NAME} not available after 30s")
                is_running.value = False
                return
            time.sleep(1.0)

        port_handler.clearPort()
        print("[heart] snapping legs to home...")

        def _servo_write_retry(write_fn, retries=3, delay=0.05):
            """Retry a servo write up to N times on comm failure."""
            for attempt in range(retries):
                result, error = write_fn()
                if result == 0:
                    return 0, error
                if attempt < retries - 1:
                    time.sleep(delay)
                    port_handler.clearPort()
            return result, error

        for sid in ALL_SERVOS:
            packet_handler.write1ByteTxRx(port_handler, sid, ADDR_TORQUE_ENABLE, 0)
            dxl_comm_result, dxl_error = _servo_write_retry(
                lambda: packet_handler.write1ByteTxRx(port_handler, sid, ADDR_MODE, 0))
            if dxl_comm_result != 0:
                print(f"[init] WARNING: servo {sid} mode write failed after retries (err={dxl_comm_result})")
            packet_handler.write1ByteTxRx(port_handler, sid, ADDR_ACCEL, 20)
            dxl_comm_result, dxl_error = _servo_write_retry(
                lambda: packet_handler.write2ByteTxRx(port_handler, sid, ADDR_TORQUE_LIMIT, 400))
            if dxl_comm_result != 0:
                print(f"[init] WARNING: servo {sid} torque_limit write failed after retries (err={dxl_comm_result})")
            packet_handler.write2ByteTxRx(port_handler, sid, ADDR_GOAL_SPEED, 800)
            packet_handler.write2ByteTxRx(port_handler, sid, ADDR_GOAL_POSITION, HOME_POSITIONS[sid])
            dxl_comm_result, dxl_error = _servo_write_retry(
                lambda: packet_handler.write1ByteTxRx(port_handler, sid, ADDR_TORQUE_ENABLE, 1))
            if dxl_comm_result != 0:
                print(f"[init] WARNING: servo {sid} torque_enable write failed after retries (err={dxl_comm_result})")

        time.sleep(3.0)

        print("[heart] switching to velocity mode")
        for sid in ALL_SERVOS:
            packet_handler.write1ByteTxRx(port_handler, sid, ADDR_TORQUE_ENABLE, 0)
            dxl_comm_result, dxl_error = _servo_write_retry(
                lambda: packet_handler.write1ByteTxRx(port_handler, sid, ADDR_MODE, 1))
            if dxl_comm_result != 0:
                print(f"[init] WARNING: servo {sid} velocity mode write failed after retries (err={dxl_comm_result})")
            packet_handler.write1ByteTxRx(port_handler, sid, ADDR_ACCEL, 0)
            dxl_comm_result, dxl_error = _servo_write_retry(
                lambda: packet_handler.write2ByteTxRx(port_handler, sid, ADDR_TORQUE_LIMIT, 1000))
            if dxl_comm_result != 0:
                print(f"[init] WARNING: servo {sid} torque_limit write failed after retries (err={dxl_comm_result})")
            dxl_comm_result, dxl_error = _servo_write_retry(
                lambda: packet_handler.write1ByteTxRx(port_handler, sid, ADDR_TORQUE_ENABLE, 1))
            if dxl_comm_result != 0:
                print(f"[init] WARNING: servo {sid} torque_enable write failed after retries (err={dxl_comm_result})")

        # Pre-register all servos for position and load sync reads
        for sid in ALL_SERVOS:
            gsread_pos.addParam(sid)
            gsread_load.addParam(sid)
            gsread_speed.addParam(sid)

    # --- DIAGNOSTIC LOGGING INFRASTRUCTURE (Tier 1 + accumulators) ---
    heart_start_mono = time.monotonic()
    ring_buffer = collections.deque(maxlen=100)
    raw_positions = {sid: HOME_POSITIONS[sid] for sid in ALL_SERVOS}
    pos_prev = {sid: 0 for sid in ALL_SERVOS}
    pos_delta_accum = 0
    dt_samples = collections.deque(maxlen=50)
    gov_clamp_count = 0
    te_cycle_counts = {sid: 0 for sid in ALL_SERVOS}
    te_during_stall = {sid: 0 for sid in ALL_SERVOS}
    stall_entry_time = {sid: 0.0 for sid in ALL_SERVOS}
    overrun_streak = 0
    overrun_buffer = []   # buffered overrun lines, drained at 1 Hz
    servo_comm_fails = {sid: 0 for sid in ALL_SERVOS}
    servo_disabled = {sid: False for sid in ALL_SERVOS}
    ref_ff_speed = 0.0
    ref_phase_angle = 0.0
    ref_phase_error = 0.0
    gov_active = False

    # --- Tier 4: Session Header ---
    try:
        with open(LOG_FILE, "a") as f:
            f.write("=" * 50 + "\n")
            f.write(f"=== HEXAPOD SESSION {datetime.datetime.now().strftime('%Y-%m-%dT%H:%M:%S')} ===\n")
            f.write(f"Pi: {socket.gethostname()} | Py: {sys.version.split()[0]} | PID: {os.getpid()}\n")
            f.write(f"Constants: STALL_THRESH={STALL_THRESHOLD} V_SCALAR={VELOCITY_SCALAR} "
                    f"KP_PHASE={KP_PHASE} OVERLOAD_TIME={OVERLOAD_PREVENTION_TIME}s "
                    f"KAPPA={KAPPA_TRANSITION}\n")
            f.write(f"Voltage: {voltage_reading:.1f}V | Home: {HOME_POSITIONS}\n")
            f.write(f"Bus: {PORT_NAME} @ {BAUDRATE} | Servos: {ALL_SERVOS}\n")
            f.write("=" * 50 + "\n")
    except:
        pass

    master_time_L, master_time_R = 0.0, 0.0
    target_dt      = 1.0 / 30.0
    last_loop_time = time.perf_counter()

    # State Smoothing (V69)
    smooth_hz        = 0.0
    smooth_turn      = 0.0
    smooth_imp_start = float(shared_impact_start.value)
    smooth_imp_end   = float(shared_impact_end.value)
    smooth_duty      = 0.55
    smooth_ff_budget = GAITS[0].get('ff_budget', GOVERNOR_FF_BUDGET)
    # Seed offsets at ZERO — all legs start in-phase (matching physical home position).
    # The CPG ramp gradually opens offsets to gait targets over ~2s, preventing the
    # phase death spiral where 100-170° initial error triggers the PhErr governor.
    smooth_offsets   = {sid: 0.0 for sid in ALL_SERVOS}
    startup_ramp_active = True   # True until all offsets converge to gait targets
    gait_switch_ramp_active = False  # True during gait-switch offset ramp

    # PhErr governor state (CPG paper Eqs. 20-21 exponential ramp)
    max_phase_error_prev = 0.0   # worst-case servo phase error from previous tick (degrees)
    pherr_gov_active     = False # True when governor is engaged (hysteresis)
    pherr_low_scale_start = 0.0  # monotonic time when governor first hit floor -- stuck timeout
    pherr_stuck_cooldown_until = 0.0  # monotonic time: suppress re-trigger for 30s after firing
    pherr_gov_suppress_until = time.monotonic() + 5.0  # suppress PhGov during startup ramp
    ph_scale             = 1.0   # current governor throttle (1.0 = no throttle)
    prev_z_flip          = 1     # track z_flip transitions (roll entry/exit)

    prev_loop_ms    = 0.0    # last frame's measured elapsed time — logged in 1Hz heartbeat
    ghost_event_flag = False  # latched True when 125C artifact seen; reset after each log tick
    comm_fail_streak = 0     # consecutive ticks with zero position reads — bus disconnect detection
    prev_gait_id    = shared_gait_id.value  # Fix 65: track gait ID to detect switches for CPG snap

    try:
        init_and_align_servos()

        while is_running.value:
            loop_start     = time.perf_counter()
            real_dt        = min(0.05, loop_start - last_loop_time)
            last_loop_time = loop_start

            shared_heartbeat.value += 1

            if loop_start - last_log_time > 1.0:
                if os.getppid() != parent_pid:
                    break
                # Check for remote STOP command (UDP from laptop)
                try:
                    cmd_data, _ = cmd_sock.recvfrom(64)
                    if cmd_data.strip() == b"STOP":
                        print("[HEART] Remote STOP received via UDP")
                        is_running.value = False
                        break
                except BlockingIOError:
                    pass
                except Exception:
                    pass

            # ----------------------------------------------------------
            # 1. READ PHYSICAL FEEDBACK via GroupSyncRead
            # ----------------------------------------------------------
            # Position read - all servos, every loop
            gsread_pos.txRxPacket()

            actual_phases = {}
            pos_read_count = 0
            for sid in ALL_SERVOS:
                if gsread_pos.isAvailable(sid, ADDR_PRESENT_POSITION, LEN_PRESENT_POSITION):
                    pos_read_count += 1
                    servo_comm_fails[sid] = 0
                    if servo_disabled[sid]:
                        servo_disabled[sid] = False  # servo responded -- re-enable
                    pos  = gsread_pos.getData(sid, ADDR_PRESENT_POSITION, LEN_PRESENT_POSITION)
                    raw_positions[sid] = pos
                    diff = pos - HOME_POSITIONS[sid]
                    angle = ((diff / ENCODER_RESOLUTION) * 360.0 * DIRECTION_MAP[sid]) % 360
                    actual_phases[sid]      = angle
                    last_actual_phases[sid] = angle
                else:
                    actual_phases[sid] = last_actual_phases[sid]
                    servo_comm_fails[sid] += 1
                    if servo_comm_fails[sid] == 30:
                        print(f"[heart] servo {sid} unresponsive for 1s — zeroing speed")
                        servo_disabled[sid] = True
                        current_per_servo[sid] = 0  # S3: don't let phantom current pollute governor

            # Bus disconnect detection — if no servo responds for 8 consecutive
            # ticks (200ms at 30Hz), the USB link is dead.  STS3215 servos in
            # velocity mode keep spinning at last speed, so detect fast.
            if pos_read_count == 0:
                comm_fail_streak += 1
            else:
                comm_fail_streak = 0
            if comm_fail_streak >= 6:
                print("[heart] serial bus error — no servo responding for 200ms")
                # Tier 3d: log bus disconnect to file (was stdout only)
                try:
                    with open(LOG_FILE, "a") as f:
                        ts = datetime.datetime.now().strftime("%H:%M:%S.%f")[:-3]
                        last_pos = " ".join(f"s{s}={raw_positions.get(s, 0)}" for s in ALL_SERVOS)
                        f.write(f"[{ts}] [BUS-DISCONNECT] streak={comm_fail_streak} last_pos=[{last_pos}]\n")
                except:
                    pass
                flush_ring_buffer("BUS-DISCONNECT-CONTEXT", 100, "serial bus lost for 200ms")
                is_running.value = False
                break

            # Telemetry read - rotate one servo per tick for full telemetry.
            # Load read every 2nd tick to save ~2-3ms serial bus time.
            # shared_servo_loads retains previous frame values on skip ticks.
            load_read_tick = (shared_heartbeat.value % 2 == 0)
            if load_read_tick:
                gsread_load.txRxPacket()
                for sid in ALL_SERVOS:
                    if gsread_load.isAvailable(sid, ADDR_PRESENT_LOAD, LEN_PRESENT_LOAD):
                        load  = gsread_load.getData(sid, ADDR_PRESENT_LOAD, LEN_PRESENT_LOAD)
                        l_mag = load & 0x3FF
                        shared_servo_loads[SERVO_LOAD_INDEX[sid]] = l_mag
            stall_active = not shared_stall_override.value

            # S2: Read present speed each tick
            gsread_speed.txRxPacket()
            for sid in ALL_SERVOS:
                if gsread_speed.isAvailable(sid, ADDR_PRESENT_SPEED, LEN_PRESENT_SPEED):
                    spd_raw = gsread_speed.getData(sid, ADDR_PRESENT_SPEED, LEN_PRESENT_SPEED)
                    shared_servo_speeds[SERVO_LOAD_INDEX[sid]] = spd_raw & 0x3FF
                    if stall_active:
                        # Latching stall logic — symmetric 3-frame entry AND exit.
                        # Wet sand produces brief stance-phase load spikes from sand
                        # resistance; a single high frame must NOT freeze the leg.
                        # Entry: counter must reach 3 before stall is declared.
                        # Exit: counter must fall to 0 before stall is cleared.
                        # During exit, a new spike increments the counter back up —
                        # stall re-latches immediately when counter hits 3 again.
                        sid_load = shared_servo_loads[SERVO_LOAD_INDEX[sid]]
                        if load_read_tick:
                            if sid_load > STALL_THRESHOLD:
                                stall_counters[sid] = min(stall_counters[sid] + 1, 3)
                            else:
                                stall_counters[sid] = max(0, stall_counters[sid] - 1)
                        prev_stalled = is_stalled[sid]
                        if stall_counters[sid] >= 3:
                            is_stalled[sid] = True
                        elif stall_counters[sid] == 0:
                            is_stalled[sid] = False
                        # counter between 1-2: maintain current stall state (no change)
                        if is_stalled[sid] != prev_stalled:
                            log_stall_event(sid, is_stalled[sid], sid_load)
                            if is_stalled[sid]:
                                stall_entry_time[sid] = time.perf_counter()
                            else:
                                te_during_stall[sid] = 0
                                stall_entry_time[sid] = 0.0
                    else:
                        # Stall override active (e.g. inverted roll): high load is
                        # intentional floor contact - do not cut leg speed.
                        stall_counters[sid] = 0
                        is_stalled[sid]     = False

            # Overload prevention: cycle TE to clear hardware overload flag before 2s cutoff.
            # Decoupled from stall_active — runs on raw load magnitude so it still fires
            # during stall_override (e.g. self-right roll) where stall detection is suppressed
            # but hardware overcurrent protection can still trip.
            # Time-based (not frame-based) so margin is invariant to loop rate jitter.
            now = time.perf_counter()
            te_cycled_this_tick = False  # max 1 TE disable per tick to limit bus load
            for sid in ALL_SERVOS:
                # TE dwell: space off/on cycle across 5 frames (100ms) instead of 2
                if te_dwell_remaining[sid] > 0:
                    te_dwell_remaining[sid] -= 1
                    if te_dwell_remaining[sid] == 0:
                        # Re-confirm velocity mode + torque limit before re-enabling
                        packet_handler.write1ByteTxRx(port_handler, sid, ADDR_MODE, 1)
                        packet_handler.write2ByteTxRx(port_handler, sid, ADDR_TORQUE_LIMIT, 1000)
                        packet_handler.write1ByteTxRx(port_handler, sid, ADDR_TORQUE_ENABLE, 1)
                    continue  # skip normal TE logic while dwelling

                load_mag = shared_servo_loads[SERVO_LOAD_INDEX[sid]]
                if load_mag > STALL_THRESHOLD:
                    if stall_sustained_start[sid] == 0.0:
                        stall_sustained_start[sid] = now
                    elif now - stall_sustained_start[sid] >= OVERLOAD_PREVENTION_TIME:
                        if overload_cycle_count[sid] < OVERLOAD_MAX_CYCLES and not te_cycled_this_tick:
                            comm1, _ = packet_handler.write1ByteTxRx(port_handler, sid, ADDR_TORQUE_ENABLE, 0)
                            te_cycled_this_tick = True
                            te_dwell_remaining[sid] = 5  # 100ms dwell before re-enable
                            overload_cycle_count[sid] += 1
                            overload_lifetime[sid] += 1
                            te_cycle_counts[sid] += 1
                            te_during_stall[sid] += 1
                            stall_dur = now - stall_sustained_start[sid]
                            ts = datetime.datetime.now().strftime("%H:%M:%S.%f")[:-3]
                            overrun_buffer.append(f"[{ts}] [TE-CYCLE] servo=s{sid} stall_dur={stall_dur:.2f}s "
                                            f"load={load_mag} cycle={overload_cycle_count[sid]}/{OVERLOAD_MAX_CYCLES}\n")
                            if comm1 == 0:  # COMM_SUCCESS
                                stall_sustained_start[sid] = 0.0
                            # else: leave timer running -- retry on next tick
                else:
                    stall_sustained_start[sid] = 0.0
                    # Decay overload counter: -1 every 30s without overload
                    if overload_cycle_count[sid] > 0 and now - overload_last_decay[sid] >= OVERLOAD_DECAY_INTERVAL:
                        overload_cycle_count[sid] -= 1
                        overload_last_decay[sid] = now

            # Rotate which servo supplies temp/voltage/current each tick -
            # individual reads on one servo, not a 6-servo batch transaction.
            telemetry_sid   = ALL_SERVOS[telemetry_index]
            telemetry_index = (telemetry_index + 1) % len(ALL_SERVOS)

            # STS3215 "Ghost Sensor" artifact: bus noise / EMI can cause the servo
            # to return a flat 125°C instead of a real reading. Treat 125 the same
            # as a comms failure - leave spike counter unchanged rather than
            # triggering a false shutdown or masking a real overheat.
            temp_read_ok = False
            current_temp_max = 0
            temp, res_t, _ = packet_handler.read1ByteTxRx(port_handler, telemetry_sid, ADDR_PRESENT_TEMP)
            if res_t == 0 and temp != GHOST_TEMP:
                current_temp_max = temp
                temp_per_servo[telemetry_sid] = temp
                temp_read_ok = True
            elif res_t == 0 and temp == GHOST_TEMP:
                ghost_event_flag = True  # latch — cleared after next 1Hz log tick

            volt, res_v, _ = packet_handler.read1ByteTxRx(port_handler, telemetry_sid, ADDR_PRESENT_VOLTAGE)
            if res_v == 0:
                voltage_reading = volt / 10.0
                shared_voltage.value = voltage_reading

            amps, res_a, _ = packet_handler.read2ByteTxRx(port_handler, telemetry_sid, ADDR_PRESENT_CURRENT)
            if res_a == 0:
                current_per_servo[telemetry_sid] = amps & 0x7FFF

            # S5: hardware error register — 6 flags in 1 byte (diagnostic, no control action)
            hw_err, res_h, _ = packet_handler.read1ByteTxRx(port_handler, telemetry_sid, ADDR_HARDWARE_ERROR)
            if res_h == 0:
                hw_error_per_servo[telemetry_sid] = hw_err

            # ----------------------------------------------------------
            # Safety Guards
            # ----------------------------------------------------------
            # Only reset spike counter when we have a confirmed safe reading.
            # Failed reads leave the counter unchanged - a string of failures
            # cannot mask a genuine overheat that was already accumulating.
            if temp_read_ok:
                if current_temp_max > TEMP_MAX:
                    temp_spike_counters[telemetry_sid] += 1
                else:
                    temp_spike_counters[telemetry_sid] = max(0, temp_spike_counters[telemetry_sid] - 1)
            temp_spike_counter = max(temp_spike_counters.values())

            if voltage_reading < VOLTAGE_MIN:
                volt_dip_counter += 1
            else:
                volt_dip_counter = max(0, volt_dip_counter - 1)

            if temp_spike_counter > 15 or volt_dip_counter > 150:  # 150 ticks = 3s debounce — extended for cold-weather sag during heavy terrain
                if temp_spike_counter > 15:
                    hot_sid = max(temp_spike_counters, key=temp_spike_counters.get)
                    reason = f"overtemp servo={hot_sid} temp={temp_per_servo[hot_sid]}C"
                else:
                    reason = "undervolt"
                print(f"[heart] safety shutdown - {reason} volt={voltage_reading:.1f}V")
                log_telemetry(voltage_reading,
                              sum(current_per_servo.values()) / 1000.0,
                              shared_speed.value, shared_turn_bias.value,
                              volt_dip_counter, temp_spike_counter, prev_loop_ms, ghost_event_flag)
                # Tier 3c: flush full ring buffer on safety shutdown
                try:
                    with open(LOG_FILE, "a") as f:
                        ts = datetime.datetime.now().strftime("%H:%M:%S.%f")[:-3]
                        temps_at_shutdown = " ".join(f"s{s}={temp_per_servo[s]}C" for s in ALL_SERVOS)
                        loads_at_shutdown = " ".join(f"s{s}={shared_servo_loads[SERVO_LOAD_INDEX[s]]}" for s in ALL_SERVOS)
                        f.write(f"[{ts}] [SHUTDOWN] trigger={reason} temps=[{temps_at_shutdown}] loads=[{loads_at_shutdown}]\n")
                except:
                    pass
                # Flush pending [H5] verbose telemetry before ring buffer dump
                if h5_buffer:
                    try:
                        with open(LOG_FILE, "a") as f:
                            f.write("".join(h5_buffer))
                        h5_buffer.clear()
                    except:
                        pass
                flush_ring_buffer("SHUTDOWN-CONTEXT", 100, reason)
                # Fix H1: zero servos immediately before disk I/O
                for _sid in ALL_SERVOS:
                    packet_handler.write2ByteTxRx(port_handler, _sid, ADDR_GOAL_SPEED, 0)
                is_running.value = False
                break

            if loop_start - last_log_time > 1.0:
                log_telemetry(voltage_reading,
                              sum(current_per_servo.values()) / 1000.0,
                              shared_speed.value, shared_turn_bias.value,
                              volt_dip_counter, temp_spike_counter, prev_loop_ms, ghost_event_flag)
                ghost_event_flag = False  # reset after logging — new ghost events latch fresh
                last_log_time = loop_start
                # Reset per-1Hz accumulators
                pos_delta_accum = 0
                gov_clamp_count = 0
                for _sid in ALL_SERVOS:
                    te_cycle_counts[_sid] = 0
                # Drain [H5] verbose telemetry buffer (rides the same 1Hz file open)
                if h5_buffer:
                    try:
                        with open(LOG_FILE, "a") as f:
                            f.write("".join(h5_buffer))
                    except:
                        pass
                    # UDP broadcast [H5] lines (fire-and-forget for live analyst)
                    try:
                        for _udp_line in h5_buffer:
                            udp_sock.sendto(_udp_line.encode("utf-8"), ("255.255.255.255", 9876))
                    except Exception:
                        pass
                    h5_buffer.clear()
                # Drain overrun buffer at 1 Hz
                if overrun_buffer:
                    try:
                        with open(LOG_FILE, "a") as f:
                            f.writelines(overrun_buffer)
                    except:
                        pass
                    overrun_buffer.clear()

            # ----------------------------------------------------------
            # 2. STATE SMOOTHING (CPG exponential ramps — Sensors-19-03705)
            # ----------------------------------------------------------
            cur_z_flip = shared_z_flip.value
            cur_roll_mode = shared_roll_mode.value
            target_hz   = (shared_speed.value * shared_x_flip.value * cur_z_flip) / 1000.0
            target_turn = shared_turn_bias.value

            # Post-roll PhErr seed: reset governor state when z_flip transitions
            # (roll exit). Prevents stale high PhErr from throttling the robot.
            if cur_z_flip != prev_z_flip:
                max_phase_error_prev = 0.0
                pherr_gov_active = False
                pherr_low_scale_start = 0.0
                ph_scale = 1.0
                prev_z_flip = cur_z_flip

            # Speed/turn: keep linear LERP (command inputs, not CPG parameters)
            lerp_rate    = min(1.0, 4.0 * real_dt)
            turn_lerp_rate = min(1.0, 2.0 * real_dt)
            smooth_hz   += (target_hz   - smooth_hz)   * lerp_rate
            smooth_turn += (target_turn - smooth_turn) * turn_lerp_rate

            # Impact angles: keep linear circular LERP (geometric, not CPG)
            d_s = (shared_impact_start.value - smooth_imp_start + 180) % 360 - 180
            smooth_imp_start = (smooth_imp_start + d_s * lerp_rate) % 360

            d_e = (shared_impact_end.value - smooth_imp_end + 180) % 360 - 180
            smooth_imp_end = (smooth_imp_end + d_e * lerp_rate) % 360

            current_gait_id = shared_gait_id.value  # single read -- eliminates TOCTOU between gait_params fetch and snap block
            gait_params = GAITS.get(current_gait_id, GAITS[0])
            t_duty      = max(0.01, min(0.99, gait_params['duty']))
            t_ff_budget = gait_params.get('ff_budget', GOVERNOR_FF_BUDGET)

            # Phase offsets target (needed by both snap block and CPG ramp below)
            t_offsets = gait_params['offsets']

            # Gait switch: ramp offsets gradually instead of snapping (replaces Fix 65 snap).
            # Snap caused 100-170° phase error because servos can't teleport. Ramp at
            # KAPPA_GAIT_SWITCH=1.5 converges in ~2.0s with phase error staying below 30°.
            if current_gait_id != prev_gait_id:
                # Duty/ff_budget are NOT snapped — the CPG ramp below handles them gradually
                # (snapping caused ~1s mismatch where duty led offsets, creating visible jerk)
                gait_switch_ramp_active = True
                prev_gait_id = current_gait_id
                # Suppress PhGov during gait-switch ramp
                pherr_gov_active = False
                ph_scale = 1.0
                max_phase_error_prev = 0.0
                pherr_low_scale_start = 0.0
                pherr_gov_suppress_until = time.monotonic() + 2.0

            # Unified kappa: slower during startup/gait-switch so duty and
            # offsets converge together (prevents duty leading offsets).
            if startup_ramp_active:
                ramp_kappa = KAPPA_STARTUP
            elif gait_switch_ramp_active:
                ramp_kappa = KAPPA_GAIT_SWITCH
            else:
                ramp_kappa = KAPPA_TRANSITION

            # Duty (ε): CPG exponential ramp (Eq. 13 — ε(t) = ε⁺ + (ε⁻−ε⁺)e^(−κΔt))
            smooth_duty = cpg_exp_ramp(smooth_duty, t_duty, ramp_kappa, real_dt)
            smooth_duty = max(0.01, min(0.99, smooth_duty))  # clamp after ramp — prevents division by near-zero in stance/air speed calc
            smooth_ff_budget = cpg_exp_ramp(smooth_ff_budget, t_ff_budget, ramp_kappa, real_dt)

            # Phase offsets (φ): CPG circular exponential ramp (Eq. 12)
            for sid in ALL_SERVOS:
                smooth_offsets[sid] = cpg_exp_ramp_circular(
                    smooth_offsets[sid], t_offsets[sid], ramp_kappa, real_dt)
            # Check convergence — all offsets within threshold of targets
            if startup_ramp_active or gait_switch_ramp_active:
                max_offset_err = max(
                    abs((smooth_offsets[sid] - t_offsets[sid] + 0.5) % 1.0 - 0.5)
                    for sid in ALL_SERVOS)
                if max_offset_err < OFFSET_CONVERGE_THRESH:
                    if startup_ramp_active:
                        startup_ramp_active = False
                    if gait_switch_ramp_active:
                        gait_switch_ramp_active = False
                    # 1s extra grace after ramp completes before governor can engage
                    pherr_gov_suppress_until = max(pherr_gov_suppress_until,
                                                   time.monotonic() + 1.0)

            # ----------------------------------------------------------
            # 3. DRIVE CALCULATIONS & SAFETY GOVERNOR
            # ----------------------------------------------------------
            hz_L = smooth_hz + smooth_turn
            hz_R = smooth_hz - smooth_turn

            stance_sweep = (smooth_imp_end - smooth_imp_start + 180) % 360 - 180
            air_sweep    = get_air_sweep(stance_sweep)

            max_safe_hz = (smooth_ff_budget / VELOCITY_SCALAR * (1.0 - smooth_duty)) / max(5.0, abs(air_sweep))

            # Clearance governor: limit Hz so chassis stays above MIN_GROUND_CLEARANCE.
            # Roll-aware: during turns, body tilt drops inside chassis corner closer
            # to ground. compute_max_clearance_hz internally adds roll_drop to the
            # clearance requirement, tightening the Hz limit proportionally to turn_bias.
            # (Sensors-19-03705 Section 3 -- bounded swing velocity for stability)
            max_clr_hz = compute_max_clearance_hz(smooth_imp_start, smooth_imp_end, smooth_duty,
                                                  min_clearance=MIN_GROUND_CLEARANCE + GOVERNOR_CLEARANCE_MARGIN,
                                                  turn_bias=smooth_turn)
            max_safe_hz = min(max_safe_hz, max_clr_hz)

            # PhErr governor: throttle Hz when servos can't track commanded phase
            # Exponential ramp (CPG paper Eqs. 20-21) — gentle near threshold, aggressive at high error
            # Suppressed during offset ramps (startup/gait-switch) to prevent death spiral
            ramp_active = startup_ramp_active or gait_switch_ramp_active
            if not ramp_active and time.monotonic() > pherr_gov_suppress_until and max_phase_error_prev >= PHERR_ENGAGE_DEG:
                pherr_gov_active = True
            elif max_phase_error_prev < PHERR_RELEASE_DEG:
                pherr_gov_active = False
            if pherr_gov_active:
                ph_scale = PHERR_FLOOR_SCALE + (1.0 - PHERR_FLOOR_SCALE) * math.exp(
                    -KAPPA_GOVERNOR * (max_phase_error_prev - PHERR_ENGAGE_DEG) / PHERR_RAMP_WIDTH)
                max_safe_hz *= ph_scale
                # Stuck timeout: if at floor scale too long, escalate to stall recovery
                if ph_scale <= PHERR_FLOOR_SCALE + 0.01 and time.monotonic() > pherr_stuck_cooldown_until:
                    if pherr_low_scale_start == 0.0:
                        pherr_low_scale_start = time.monotonic()
                    elif (time.monotonic() - pherr_low_scale_start) > PHERR_STUCK_TIMEOUT:
                        for sid in ALL_SERVOS:
                            is_stalled[sid] = True  # triggers existing stall/wiggle recovery
                            stall_counters[sid] = 3  # latch stall through normal exit logic
                        pherr_low_scale_start = 0.0
                        pherr_stuck_cooldown_until = time.monotonic() + 30.0  # suppress re-trigger
                else:
                    pherr_low_scale_start = 0.0
            else:
                ph_scale = 1.0  # governor inactive -- no throttle
                pherr_low_scale_start = 0.0

            # Layer 4: Brownout prevention -- throttle Hz when battery sags (Fix 153)
            # Ramps max_safe_hz from 100% at BROWNOUT_VOLTAGE_START down to BROWNOUT_SPEED_FLOOR at VOLTAGE_MIN.
            # Reduces servo current draw before shutdown threshold, preventing brownout cascade.
            # Combined worst case with PhErr: 0.45 * 0.5 = 0.225x nominal, caught by Hz floor below.
            if voltage_reading < BROWNOUT_VOLTAGE_START:
                brownout_scale = max(BROWNOUT_SPEED_FLOOR,
                    BROWNOUT_SPEED_FLOOR + (1.0 - BROWNOUT_SPEED_FLOOR)
                    * (voltage_reading - VOLTAGE_MIN) / (BROWNOUT_VOLTAGE_START - VOLTAGE_MIN))
                max_safe_hz *= brownout_scale
            else:
                brownout_scale = 1.0

            # Layer 5: Current budget governor
            # Mutual exclusion with PhErr (ph_scale<1.0) prevents cascade
            fleet_current_ma = sum(current_per_servo.values())
            if fleet_current_ma > CURRENT_BUDGET_WARN_MA and ph_scale >= 1.0:
                current_scale = max(CURRENT_BUDGET_FLOOR,
                    CURRENT_BUDGET_FLOOR + (1.0 - CURRENT_BUDGET_FLOOR)
                    * (CURRENT_BUDGET_HARD_MA - fleet_current_ma)
                    / (CURRENT_BUDGET_HARD_MA - CURRENT_BUDGET_WARN_MA))
                max_safe_hz *= current_scale

            # Hz floor: prevents PhErr positive feedback (low Hz -> low FF -> higher PhErr -> lower Hz)
            # Capped by clearance governor so floor never causes ground scraping
            max_safe_hz = max(min(MIN_STANCE_HZ, max_clr_hz), max_safe_hz)

            gov_active = (abs(hz_L) > max_safe_hz + 0.001 or abs(hz_R) > max_safe_hz + 0.001)
            hz_L = max(-max_safe_hz, min(max_safe_hz, hz_L))
            hz_R = max(-max_safe_hz, min(max_safe_hz, hz_R))


            cycle_hz_L, cycle_hz_R = abs(hz_L), abs(hz_R)
            if cycle_hz_L > 0.001: master_time_L = (master_time_L + cycle_hz_L * real_dt) % 1.0
            if cycle_hz_R > 0.001: master_time_R = (master_time_R + cycle_hz_R * real_dt) % 1.0

            # Phase Resync for stability
            if abs(smooth_turn) < 0.05 and abs(smooth_hz) > 0.01 and (hz_L * hz_R) > 0:
                clock_diff = (master_time_L - master_time_R + 0.5) % 1.0 - 0.5
                if abs(clock_diff) > 0.005:
                    decay = clock_diff * min(1.0, 8.0 * real_dt)
                    master_time_L = (master_time_L - decay / 2) % 1.0
                    master_time_R = (master_time_R + decay / 2) % 1.0
                # else: clocks are within 0.005 cycles - close enough, let decay converge naturally

            # ----------------------------------------------------------
            # 4. KINEMATIC CONTROLLER (Pure Math Flow)
            # ----------------------------------------------------------
            max_phase_error_frame = 0.0  # worst-case servo error this tick
            tick_max_pherr = 0.0        # redundant tracker (used in feedback block)
            for sid in ALL_SERVOS:
                target_phase = 0.0  # safe default -- overwritten by Buehler calc or roll mode
                leg_hz    = hz_L if sid in LEFT_SERVOS else hz_R
                is_rev_leg = (leg_hz < 0)

                if cur_roll_mode:
                    # Counter-rotating roll: bypass Buehler clock entirely.
                    # Front/rear pairs spin opposite directions; sin(±35° splay)
                    # creates additive rolling torque about the body long axis.
                    base_speed = shared_speed.value
                    if sid in ROLL_FRONT_SERVOS:
                        raw_speed = float(base_speed)
                    elif sid in ROLL_REAR_SERVOS:
                        raw_speed = float(-base_speed)
                    else:  # middle servos (3, 6) — zero splay, no roll torque but
                        raw_speed = float(base_speed)  # spin to prevent kickstand effect
                    # Normal direction corrections for physical servo mounting
                    if DIRECTION_MAP[sid] < 0:
                        raw_speed = -raw_speed
                    if sid in LEFT_SERVOS:
                        raw_speed = -raw_speed
                    final_speed = max(-SERVO_SPEED_GOVERNOR_CAP, min(SERVO_SPEED_GOVERNOR_CAP, int(raw_speed)))
                elif is_stalled[sid] or servo_disabled[sid] or abs(leg_hz) < 0.001:
                    final_speed = 0
                    if sid == 1:
                        ref_ff_speed = 0.0
                        ref_phase_angle = actual_phases.get(sid, 0.0)
                        ref_phase_error = 0.0
                else:
                    master_time   = master_time_L if sid in LEFT_SERVOS else master_time_R
                    current_phase = actual_phases.get(sid, 0.0)
                    t_leg         = (master_time + smooth_offsets[sid]) % 1.0

                    target_phase = get_buehler_angle(
                        t_leg, smooth_duty, smooth_imp_start, smooth_imp_end, is_rev_leg)

                    # Reuse stance_sweep / air_sweep already computed in section 3
                    if t_leg <= smooth_duty:
                        deg_per_sec = (abs(stance_sweep) * abs(leg_hz)) / smooth_duty
                    else:
                        deg_per_sec = (abs(air_sweep) * abs(leg_hz)) / (1.0 - smooth_duty)

                    ff_speed = min(FEEDFORWARD_CAP, deg_per_sec * VELOCITY_SCALAR)

                    if sid == 1:
                        ref_ff_speed = ff_speed
                        ref_phase_angle = target_phase
                        ref_phase_error = (target_phase - current_phase + 180) % 360 - 180

                    error       = target_phase - current_phase
                    short_error = (error + 180) % 360 - 180
                    max_phase_error_frame = max(max_phase_error_frame, abs(short_error))

                    if t_leg > smooth_duty:
                        # Air phase: guard prevents backward-error signal during fast
                        # forward return sweep.  Fires only in air phase to avoid
                        # runaway when the leg overshoots during stance.
                        # Linear ramp over 10° transition zone eliminates discontinuity
                        # at the ±90° boundary (was a hard re-wrap).
                        transition_deg = 10.0
                        if not is_rev_leg and short_error < -80:
                            depth = -80.0 - short_error  # 0 at -80, 10 at -90, >10 beyond
                            blend = min(1.0, depth / transition_deg)
                            short_error += 360 * blend
                        elif is_rev_leg and short_error > 80:
                            depth = short_error - 80.0   # 0 at +80, 10 at +90, >10 beyond
                            blend = min(1.0, depth / transition_deg)
                            short_error -= 360 * blend

                    correction = short_error * KP_PHASE if abs(short_error) >= PHERR_DEADBAND else 0.0
                    directed_ff = -ff_speed if is_rev_leg else ff_speed  # only flip feedforward, not correction
                    raw_speed = directed_ff + correction
                    tick_max_pherr = max(tick_max_pherr, abs(short_error))
                    if sid in LEFT_SERVOS and not cur_roll_mode:
                        raw_speed = -raw_speed

                    final_speed = max(-WALKING_SPEED_CAP, min(WALKING_SPEED_CAP, int(raw_speed)))

                # Capture for [H5] verbose telemetry (no overhead when disabled -- just dict writes)
                cmd_speeds[sid] = final_speed
                phase_angles[sid] = actual_phases.get(sid, 0.0)
                target_angles[sid] = target_phase if not (is_stalled[sid] or servo_disabled[sid] or abs(leg_hz) < 0.001) else phase_angles[sid]

                abs_speed = int(abs(final_speed))
                speed_val = (abs_speed | 0x8000) if final_speed < 0 else abs_speed
                group_sync_write.addParam(sid, [speed_val & 0xff, (speed_val >> 8) & 0xff])

            group_sync_write.txPacket()
            group_sync_write.clearParam()

            max_phase_error_prev = max_phase_error_frame  # carry to next tick for governor

            # ----------------------------------------------------------
            # 5. RING BUFFER + ACCUMULATOR UPDATES (no disk I/O)
            # ----------------------------------------------------------
            tick_mono = time.monotonic() - heart_start_mono
            loop_dt_ms = (time.perf_counter() - loop_start) * 1000
            stall_bitmap = sum((1 << i) for i, sid in enumerate(ALL_SERVOS) if is_stalled[sid])
            ring_buffer.append((
                tick_mono,
                raw_positions.get(2, 0), raw_positions.get(3, 0), raw_positions.get(4, 0),
                raw_positions.get(1, 0), raw_positions.get(6, 0), raw_positions.get(5, 0),
                shared_servo_loads[SERVO_LOAD_INDEX[2]], shared_servo_loads[SERVO_LOAD_INDEX[3]],
                shared_servo_loads[SERVO_LOAD_INDEX[4]], shared_servo_loads[SERVO_LOAD_INDEX[1]],
                shared_servo_loads[SERVO_LOAD_INDEX[6]], shared_servo_loads[SERVO_LOAD_INDEX[5]],
                shared_speed.value, shared_turn_bias.value,
                ref_ff_speed, ref_phase_angle, shared_gait_id.value,
                stall_bitmap, loop_dt_ms, gov_active,
                shared_x_flip.value, shared_z_flip.value
            ))

            # Position delta accumulator (handles encoder wraparound)
            for sid in ALL_SERVOS:
                rp = raw_positions.get(sid, 0)
                if pos_prev[sid] > 0:
                    delta = abs(rp - pos_prev[sid])
                    if delta > 2048:
                        delta = 4096 - delta
                    pos_delta_accum += delta
                pos_prev[sid] = rp

            dt_samples.append(loop_dt_ms)
            if gov_active:
                gov_clamp_count += 1

            # [H5] verbose telemetry: servo positions + commanded speeds + phase angles at 5Hz (every 6th tick at 30Hz)
            h5_counter += 1
            if VERBOSE_TELEMETRY and h5_counter % 6 == 0:
                t_off = time.monotonic() - heart_start_mono
                pos_str = ",".join(str(raw_positions.get(sid, 0)) for sid in ALL_SERVOS)
                spd_str = ",".join(str(cmd_speeds[sid]) for sid in ALL_SERVOS)
                pha_str = ",".join(f"{phase_angles[sid]:.1f}" for sid in ALL_SERVOS)
                tgt_str = ",".join(f"{target_angles[sid]:.1f}" for sid in ALL_SERVOS)
                h5_buffer.append(
                    f"[H5] T+{t_off:.3f} P:{pos_str} S:{spd_str} "
                    f"Ph:{pha_str} PhT:{tgt_str} FF:{ref_ff_speed:.0f} G:{int(gov_active)} D:{smooth_duty:.2f}\n")

            # ----------------------------------------------------------
            # 6. PRECISION TIMING
            # ----------------------------------------------------------
            elapsed_time = time.perf_counter() - loop_start
            prev_loop_ms = elapsed_time * 1000  # stored for next 1Hz log tick
            sleep_time   = target_dt - elapsed_time
            if sleep_time > 0.002:
                time.sleep(sleep_time - 0.002)
            while time.perf_counter() - loop_start < target_dt:
                pass

            # Loop overrun detection (30Hz loop = 33.33ms target; flag above 33.5ms)
            if prev_loop_ms > 33.5:
                overrun_streak += 1
                ts = datetime.datetime.now().strftime("%H:%M:%S.%f")[:-3]
                overrun_buffer.append(f"[{ts}] [OVERRUN] dt={prev_loop_ms:.1f}ms at T+{tick_mono:.3f}\n")
                if overrun_streak >= 3 and (overrun_streak == 3 or overrun_streak % 50 == 0):
                    flush_ring_buffer("OVERRUN-CONTEXT", 50, f"{overrun_streak} consecutive overruns")
            else:
                overrun_streak = 0

    except Exception as e:
        print(f"[heart] fatal error: {e}")
    finally:
        print("[heart] shutting down, returning legs to home...")
        port_handler.clearPort()
        for sid in ALL_SERVOS:
            packet_handler.write2ByteTxRx(port_handler, sid, ADDR_GOAL_SPEED, 0)
        time.sleep(0.1)
        flush_stall_log()
        for sid in ALL_SERVOS:
            packet_handler.write1ByteTxRx(port_handler, sid, ADDR_TORQUE_ENABLE, 0)
            packet_handler.write1ByteTxRx(port_handler, sid, ADDR_MODE, 0)
            packet_handler.write1ByteTxRx(port_handler, sid, ADDR_ACCEL, 20)
            packet_handler.write2ByteTxRx(port_handler, sid, ADDR_TORQUE_LIMIT, 400)
            packet_handler.write2ByteTxRx(port_handler, sid, ADDR_GOAL_SPEED, 800)
            packet_handler.write2ByteTxRx(port_handler, sid, ADDR_GOAL_POSITION, HOME_POSITIONS[sid])
            packet_handler.write1ByteTxRx(port_handler, sid, ADDR_TORQUE_ENABLE, 1)
        time.sleep(3.0)
        for sid in ALL_SERVOS:
            # V0.5.01 safety addition: explicitly zero speed in case mode switch back to velocity failed, 
            # which would leave the legs spinning at last speed instead of holding position.
            # packet_handler.write2ByteTxRx(port_handler, sid, ADDR_GOAL_SPEED, 0)  # safety: zero velocity in case mode switch faile
            packet_handler.write2ByteTxRx(port_handler, sid, ADDR_GOAL_SPEED, 0)  # safety: zero velocity before torque disable to prevent runaway motion
            packet_handler.write1ByteTxRx(port_handler, sid, ADDR_TORQUE_ENABLE, 0)
        port_handler.closePort()
        try:
            udp_sock.close()
            cmd_sock.close()
        except Exception:
            pass
        print("[heart] offline")


# =================================================================
# PROCESS 1: THE BRAIN (MISSION SEQUENCER)
# =================================================================

class EmergencyStopException(Exception):
    pass

# V0.5.01 addition: tactical sleep function that monitors both the is_running flag and the heart process's liveness,
#  to ensure that if the heart crashes during a critical phase (e.g. self-righting roll), the brain detects it and triggers 
# a clean shutdown instead of continuing blindly.
def tactical_sleep(duration, running_flag, heart_process):
    """
    Monitors is_running flag AND gait_process.is_alive() during tactical
    phases so a Heart crash triggers a clean Brain abort.
    """
    start_time = time.time()
    while time.time() - start_time < duration:
        if not running_flag.value:
            raise EmergencyStopException("Safety shutdown triggered by hardware.")
        if not heart_process.is_alive():
            raise EmergencyStopException("Heart process has died unexpectedly.")
        time.sleep(0.1)



# ===================================================================
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
