Robiswell/Euler_Rover_2026/sim_nav.py

#!/usr/bin/env python3
"""
sim_nav.py — Brain-level autonomous navigation test suite

Tests the 8-state FSM, serial parser, sensor processing, cliff detection,
terrain overlay, and graceful degradation using synthetic sensor frames.
No hardware dependencies (no serial, no GPIO, no scservo_sdk).

Usage:
    python sim_nav.py

Output: Named checks (N1-N11), PASS/FAIL per check, diagnostics on failure,
overall summary at bottom.
"""

import sys
import io
import math
import time
import collections

sys.stdout = io.TextIOWrapper(sys.stdout.buffer, encoding="utf-8", errors="replace")

# =========================================================================
#  REPLICATED NAV CODE
#  Replicated from final_full_gait_test.py -- keep in sync
# =========================================================================

# --- Nav tunable constants ---
CRUISE_SPEED = 400
TRIPOD_CRUISE_SPEED = 450
SLOW_SPEED = 200
BACKWARD_SPEED = 200
REAR_UNSAFE_DEBOUNCE = 4
LOAD_WINDOW_SIZE = 25
ROCKY_VARIANCE_THRESH = 5000
SINKING_TREND_THRESH = 30
SINKING_LOAD_THRESH  = 400
SINKING_ACCEL_THRESH = 2.0
MAX_TURN_BIAS = 0.20
PIVOT_TURN_BIAS = 0.22
STALL_LOAD_THRESHOLD_NAV = 500
STALL_SUSTAIN_S = 1.5
SLOPE_PITCH_DEG = 15
HEAVY_TERRAIN_LOAD = 400
LIGHT_TERRAIN_LOAD = 200
TERRAIN_SUSTAIN_S = 2.0
LOAD_ASYMMETRY_THRESHOLD = 200
FLICKER_WINDOW_S = 2.0
FLICKER_COUNT_THRESHOLD = 3
MISSION_TIMEOUT_S = 90
FINISH_WALL_DIST_CM = 10
FINISH_WALL_SUSTAIN_S = 2.0

# --- CSV column indices ---
CSV_COLS = 20
IDX_TS = 0
IDX_FDL, IDX_FCF, IDX_FCD, IDX_FDR = 1, 2, 3, 4
IDX_RDL, IDX_RCF, IDX_RCD, IDX_RDR = 5, 6, 7, 8
IDX_QW, IDX_QX, IDX_QY, IDX_QZ = 9, 10, 11, 12
IDX_AX, IDX_AY, IDX_AZ = 13, 14, 15
IDX_GX, IDX_GY, IDX_GZ = 16, 17, 18
IDX_UPSIDE = 19

# Distance classification constants
DIST_DANGER = 3
DIST_NEAR = 2
DIST_CAUTION = 1
DIST_CLEAR = 0
DIST_UNKNOWN = 1  # treat unknown same as caution

# Nav states
NAV_FORWARD = 0
NAV_SLOW_FORWARD = 1
NAV_ARC_LEFT = 2
NAV_ARC_RIGHT = 3
NAV_BACKWARD = 4
NAV_PIVOT_TURN = 5
NAV_WIGGLE = 6
NAV_STOP_SAFE = 7

NAV_STATE_NAMES = {
    0: "FORWARD", 1: "SLOW_FWD", 2: "ARC_L", 3: "ARC_R",
    4: "BACKWARD", 5: "PIVOT", 6: "WIGGLE", 7: "STOP_SAFE",
}

# States where heading-hold is active. Grouped so slow<->fast forward transitions
# (triggered by obstacle proximity) do not reset yaw baseline mid-cruise.
CRUISING_STATES = (NAV_FORWARD, NAV_SLOW_FORWARD)

NAV_IMU_SETTLE_TICKS = 5  # ignore IMU safety checks for first 0.5s (BNO085 convergence)
CLIFF_WARMUP = 5  # frames before cliff detection active (sensor settle)
RAPID_ROTATION_THRESHOLD = 3.5  # rad/s (~200 deg/s) -- walking oscillation peaks ~2.0

# Suppress brain_log in test context
def brain_log(msg):
    pass


def _parse_arduino_csv(line):
    """Parse a 20-column CSV line from Arduino sensor hub into a frame dict.
    Returns dict or None on parse failure."""
    if not line:
        return None
    line = line.strip()
    if not line or line.startswith("timestamp_ms"):
        return None
    parts = line.split(",")
    if len(parts) != CSV_COLS:
        return None
    try:
        ts = int(parts[IDX_TS])
        dists = []
        for i in range(IDX_FDL, IDX_RDR + 1):
            v = float(parts[i])
            dists.append(v)
        qw = float(parts[IDX_QW])
        qx = float(parts[IDX_QX])
        qy = float(parts[IDX_QY])
        qz = float(parts[IDX_QZ])
        ax = float(parts[IDX_AX])
        ay = float(parts[IDX_AY])
        az = float(parts[IDX_AZ])
        gx = float(parts[IDX_GX])
        gy = float(parts[IDX_GY])
        gz = float(parts[IDX_GZ])
        upside = int(float(parts[IDX_UPSIDE]))
    except (ValueError, IndexError):
        return None

    # Upside-down remap: swap front/rear, preserve body-frame left/right
    if upside == 1:
        dists = dists[4:8] + dists[0:4]
        upside = 0

    # Clamp distances: preserve -1 sentinel, cap max at 450
    for i in range(len(dists)):
        if dists[i] == -1:
            continue
        if dists[i] > 450:
            dists[i] = 450.0

    return {
        "timestamp_ms": ts,
        "FDL": dists[0], "FCF": dists[1], "FCD": dists[2], "FDR": dists[3],
        "RDL": dists[4], "RCF": dists[5], "RCD": dists[6], "RDR": dists[7],
        "qw": qw, "qx": qx, "qy": qy, "qz": qz,
        "ax": ax, "ay": ay, "az": az,
        "gx": gx, "gy": gy, "gz": gz,
        "upside_down": upside,
    }


def classify_distance(cm):
    """Classify a single distance reading into severity level."""
    if cm is None:
        return DIST_UNKNOWN
    if cm == -1:
        return DIST_DANGER
    if cm < 0:
        return DIST_UNKNOWN
    if cm <= 20:
        return DIST_DANGER
    if cm <= 30:
        return DIST_NEAR
    if cm <= 50:
        return DIST_CAUTION
    return DIST_CLEAR


def classify_sectors(frame):
    """Classify sectors with majority voting to reject outlier sensors.
    Front (3 sensors): median severity rejects one outlier.
    Left/Right (2 sensors): if readings disagree by 2+ levels,
    downgrade to (max - 1) instead of trusting the worst reading.
    Blind-zone (-1.0) is hard DANGER -- not outvotable (confirmed by
    double-ping in firmware, so physically real)."""
    # Check raw readings for blind-zone before classification
    front_blind = any(frame[k] == -1 for k in ("FDL", "FCF", "FDR"))
    left_blind = any(frame[k] == -1 for k in ("FDL", "RDL"))
    right_blind = any(frame[k] == -1 for k in ("FDR", "RDR"))

    # Classify individual sensors to severity levels
    fdl = classify_distance(frame["FDL"])
    fcf = classify_distance(frame["FCF"])
    fdr = classify_distance(frame["FDR"])
    rdl = classify_distance(frame["RDL"])
    rdr = classify_distance(frame["RDR"])

    # Front sector (3 sensors): median rejects one outlier
    front = sorted([fdl, fcf, fdr])[1]
    if front_blind:
        front = DIST_DANGER  # blind zone not outvotable

    # Left sector (2 sensors): downgrade if disagree by 2+ levels
    left_max = max(fdl, rdl)
    if left_blind:
        left = DIST_DANGER
    elif left_max - min(fdl, rdl) >= 2:
        left = left_max - 1  # disagreement downgrade
    else:
        left = left_max

    # Right sector (2 sensors): downgrade if disagree by 2+ levels
    right_max = max(fdr, rdr)
    if right_blind:
        right = DIST_DANGER
    elif right_max - min(fdr, rdr) >= 2:
        right = right_max - 1  # disagreement downgrade
    else:
        right = right_max

    return front, left, right


def speed_scale_from_front(front_class):
    """Map front sector classification to speed multiplier."""
    if front_class == DIST_CLEAR:
        return 1.0
    if front_class == DIST_CAUTION:
        return 0.7
    if front_class == DIST_NEAR:
        return 0.45
    if front_class == DIST_DANGER:
        return 0.0
    return 0.7  # UNKNOWN


class CliffDetector:
    """Detects cliffs using ground EMA + delta + consecutive frame confirmation."""

    def __init__(self, alpha=0.2):
        self._alpha = alpha
        self._ground_ema = 25.0
        self._consecutive_front = 0
        self._consecutive_rear = 0
        self._warmup_frames = 0

    def update(self, fcd, rcd):
        """Update cliff detection with new FCD and RCD readings.
        Returns (front_cliff, rear_cliff) booleans."""
        self._warmup_frames += 1
        front_cliff = self._check_cliff(fcd, is_front=True)
        rear_cliff = self._check_cliff(rcd, is_front=False)
        return front_cliff, rear_cliff

    def _check_cliff(self, reading, is_front):
        """Check single cliff sensor. Returns True if cliff confirmed."""
        counter_attr = "_consecutive_front" if is_front else "_consecutive_rear"
        count = getattr(self, counter_attr)

        if reading == -1:
            setattr(self, counter_attr, 0)
            return False

        # 300.0 = max range timeout (acoustic scatter on sand) -- treat as blind zone
        if reading >= 300.0:
            setattr(self, counter_attr, 0)
            return False

        if reading is None:
            setattr(self, counter_attr, count + 1)
            return count + 1 >= 2

        # Update ground EMA with valid low readings (runs during warmup so baseline converges)
        if 0 < reading <= 40:
            self._ground_ema = self._alpha * reading + (1 - self._alpha) * self._ground_ema

        # Warmup: suppress detection but EMA already updated above
        if self._warmup_frames <= CLIFF_WARMUP:
            return False

        # Cliff candidate: absolute > 30 OR delta > EMA + 10
        is_candidate = (reading > 30) or (reading > self._ground_ema + 10)

        if is_candidate:
            setattr(self, counter_attr, count + 1)
            return count + 1 >= 2
        else:
            setattr(self, counter_attr, 0)
            return False


def compute_imu(frame):
    """Extract orientation, vibration, angular rate from frame."""
    w, x, y, z = frame["qw"], frame["qx"], frame["qy"], frame["qz"]

    qmag = w*w + x*x + y*y + z*z
    if qmag < 0.5:
        return {
            "pitch_deg": 0.0, "roll_deg": 0.0, "yaw_deg": 0.0,
            "pitch_rad": 0.0, "roll_rad": 0.0, "yaw_rad": 0.0,
            "upright_quality": 0.0,
            "accel_mag": 9.81, "angular_rate": 0.0,
            "forward_accel": 0.0,
        }

    sinp = 2.0 * (w * y - z * x)
    sinp = max(-1.0, min(1.0, sinp))
    pitch_rad = math.asin(sinp)

    roll_rad = math.atan2(2.0 * (w * x + y * z),
                          1.0 - 2.0 * (x * x + y * y))

    yaw_rad = math.atan2(2.0 * (w * z + x * y),
                         1.0 - 2.0 * (y * y + z * z))

    upright_quality = min(math.cos(abs(pitch_rad)),
                          math.cos(abs(roll_rad)))

    accel_mag = math.sqrt(frame["ax"]**2 + frame["ay"]**2 + frame["az"]**2)
    angular_rate = math.sqrt(frame["gx"]**2 + frame["gy"]**2 + frame["gz"]**2)

    return {
        "pitch_deg": math.degrees(pitch_rad),
        "roll_deg": math.degrees(roll_rad),
        "yaw_deg": math.degrees(yaw_rad),
        "pitch_rad": pitch_rad,
        "roll_rad": roll_rad,
        "yaw_rad": yaw_rad,
        "upright_quality": upright_quality,
        "accel_mag": accel_mag,
        "angular_rate": angular_rate,
        "forward_accel": frame.get("ax", 0.0),
    }


def compute_turn_intensity(frame):
    """Compute turn intensity from diagonal distances.
    Positive = left is freer = should turn left.
    Range [-1, +1]."""
    fdl = frame["FDL"]
    fdr = frame["FDR"]
    fdl_eff = 25.0 if (fdl is None or fdl == -1) else fdl
    fdr_eff = 25.0 if (fdr is None or fdr == -1) else fdr
    # FIX 23: proximity scaling -- closer obstacle = more dramatic arc turn.
    closest = min(fdl_eff, fdr_eff)
    proximity_scale = max(0.25, min(1.0, (60.0 - closest) / 40.0))
    return math.tanh((fdl_eff - fdr_eff) / 50.0) * proximity_scale


def compute_battery_mult(voltage_value):
    """Compute battery speed multiplier from voltage."""
    VOLTAGE_MIN = 10.5
    if voltage_value < VOLTAGE_MIN:
        return 0.0
    if voltage_value < VOLTAGE_MIN + 0.5:
        return 0.7
    return 1.0


def compute_servo_loads(loads_snapshot):
    """Analyze servo load array snapshot."""
    if not loads_snapshot or all(v < 0 for v in loads_snapshot):
        return {"avg_load": 0, "load_asymmetry": 0, "left_avg": 0, "right_avg": 0}
    valid = [v for v in loads_snapshot if v >= 0]
    if not valid:
        return {"avg_load": 0, "load_asymmetry": 0, "left_avg": 0, "right_avg": 0}
    avg_load = sum(valid) / len(valid)
    load_asymmetry = max(valid) - min(valid)
    left_indices = [0, 1, 2]
    right_indices = [3, 4, 5]
    left_vals = [loads_snapshot[i] for i in left_indices if loads_snapshot[i] >= 0]
    right_vals = [loads_snapshot[i] for i in right_indices if loads_snapshot[i] >= 0]
    left_avg = sum(left_vals) / len(left_vals) if left_vals else 0
    right_avg = sum(right_vals) / len(right_vals) if right_vals else 0
    return {
        "avg_load": avg_load,
        "load_asymmetry": load_asymmetry,
        "left_avg": left_avg,
        "right_avg": right_avg,
    }
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
