Robiswell/Euler_Rover_2026/(notices)

Notices in the files:
README.md:
License: PolyForm Noncommercial 1.0.0
